eagletrt/handcart-hw/README.md

# Handcart

Battery charger controller board.
