eagletrt/handcart-hw/docs/hat_minimum.dxf

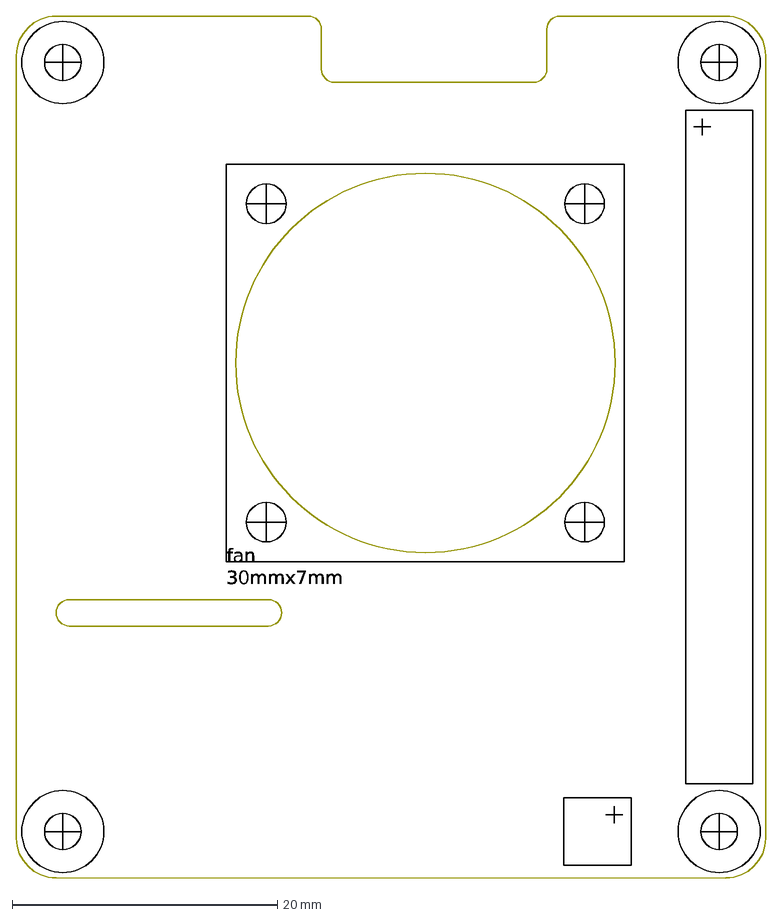
[picture p10: CAD file, 2021-08-04]
docs/hat_minimum.dxf
fan 30mmx7mm
