eagletrt/handcart-hw/(threads)

Thread 2 (2021-11-30):

Board v2 problems

volpx, 2021-11-30:

volpx, 2021-12-01:
- [ ] missing holes
- [ ] missing MCP reset stuff

volpx, 2021-12-01:
- [ ] Update shutdown labels

Closed 2024-01-30.

Thread 4 (2021-12-13):

SD relay coil has to be powered in a different way

mattebit, 2021-12-13:
Atm, the shutdown relay coil in the PCB cannot be closed by the raspy, because it needs an external action with the reset button

Closed 2024-01-30.

Thread 5 (2022-01-18):

Add LED support

mattebit, 2022-01-18:
Need to add support for RGB leds.
The GPIO pins
- 12
- 13
- 16
have to command a mosfet each, which will drive each LED channel (red green and blue).  Mosfets has to be added (rated for led current)
The connector to connect the leds to will have the three outputs from the mosfets + a GND pin, a +12V and a +5V.

mattebit, 2024-01-30:
Led added in new design

Closed 2024-01-30.

Thread 6 (2022-05-31):

LEDs logic is inverted

volpx, 2022-05-31:
All three led have the logic inverted from the transistors driving them according to an SCS signal.
TS_OFF led short to gnd should result in led off
_FAULT led short to gnd should result in led on

Closed 2024-01-30.

Thread 8 (2023-02-16):

Move the BMS connector, too close to shutdown relay K1, clip is not easy to press

mattebit, 2023-02-16:

Closed 2024-01-30.

Thread 9 (2023-06-25):

Add a RS232 connector or change the one already present

mattebit, 2023-06-25:
There is the need to connect a laptop to the handcart via serial, so the RS232 connector should be connected to the raspberry serial pins. At the moment the RS232 connector is connected to the brusa.
A switch could be added to choose to connect from the laptop to the raspi or to the brusa.

Closed 2024-01-30.

Thread 10 (2023-09-26):

Put the BMS connector directly on the PCB instead of having molex->cable->panel connector

mattebit, 2023-09-26:
Use the same TE ampseal connectors as the porchetto and ecu. Check also if it is possible to put another one for the brusa

Closed 2024-01-30.

Thread 12 (2023-10-27):

schematic review

thomasnonis, 2023-10-27:
## General
- [x] use a 0.050 in grid (realign everything after changing it)
- [x] Rnets are 4x0603, not 4x0612
- [x] specify the unit of resistor values (e.g. 22 -> 22R)
- [x] Add feedbacks for every single stupid signal (within reason, possibly analog)
- [x] RASPI with a "I", not "Y"
- [x] Place connectors together with their respective circuits in their sheets
- [x] Don't use custom symbols if not needed. Also keep body diode

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

## Power
- [x]  if +12V rail is used just for SDC, use VSD label
- [x] consider 2 separate fuses, one fo +12V and one for VSD
- [x]  place PWR_FLAGs at power net sources
- [x]  add LEDs for every generated power rail
- [x]  add fuse on main power input
- [x]  add fuse or pptc on dcdc2510 output
- [x] TSAL must be supplied by 24V
- [x] consider removing 12V aux supply from charger connector and replace them with spares. Then add spare power supply connector

## Connectors
- [x] add transient voltage protections (TVS) on all I/Os that interface with external systems/humans
- [x] add LPF and over/undervoltage protection (diode shunts) on all inputs
- [x] name every connector
- [x] why BMS is powered by 12V?
- [x] why does J10 have 6 pins instead of 4?
- [x] Molex outputs is not a great descriptive name. Just outputs would be better

## Shutdown
- [ ] consider finding new relay for 24V operation
- [x] why this specific mosfet to drive the relay? Consider 2N7002 which is already used in other circuits
- [x] both nets are inputs?
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
- [x] SD diode probably useless
- [x] Consider placing relay directly after VDC generation

## Discharge
- [x] why here pull-down is 10k and in other parts is 330k?
- [x] Don't use R_Small symbols. There is plenty of space, no need to make everything hyper compact

## Raspberry
- [x] consider adding a solder jumper on the 3V3 rail of the RPI. It has an internal regulator, which might interfere with the TexDCDC and result in unnecessary problems or power draw
- [x] Why 10k as I2C pull-up?

## Output
- [x] Why gate series resistors are 22R while they are 33R in other places?
- [x] Why 2512 resistors for just 200mW?
- [x] use TSAL in easy mode (just send on-off signal)
- [ ] think about power dissipation of all mosfets
- [x] no addressable LED strips :(

Kirseline, 2023-11-16:
[ ] Add reverse polarity protection on main power input
[ ] different CS for different spi chips
[ ] lower filter frequency on shutdown feedback

Closed 2023-12-15.

Thread 13 (2023-12-15):

Review

thomasnonis, 2023-12-15:
# Schematic

## General
- [ ] Use the standard part fields as in the template and fill them
- [ ] All datasheets must be local and with the core information highlighted
- [ ] Molex connectors are usually numbered Top-Bottom (check). Use correct symbols.
- [ ] 00_proj-lib is not included in the path

## Root

### Power in
- [ ] Eagle_Connectors:17762791 is not on the team library
- [ ] The Zener on the reverse polarity mosfet probably has too low of a voltage. It will not be able to carry 10A
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
- [ ] Reverse polarity protection mosfet footprint is wrong. Probably must be GDS or SDG
- [ ] Simply renaming a power port after placement will not change its net name. Need to create new port to actually have net renamed
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
- [ ] Do not change reference designators just on one side. These are not linked anymore
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

### To charger
- [ ] Charger connector footprint not in library

### Additional fan
- [ ] Sure that 1N4148W is SOD323?

# Layout
- [ ] Use filled zone instead of traces. Better for thermal reliefs
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
- [ ] This artifact brings no advantages. Decrease the zone's clearances or minimum widths to add more thermal relief. If this size is needed, might as well use fully filled zone (bad for soldering though)
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
- [ ] Is one VIA enough? Verify
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
- [ ] In general, routing traces as close as possible to each other is not good practice. If there is space, leave ample clearance
- [ ] Trace width is smaller at source and larger at load. Should be equal or the opposite
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
- [ ] If traces have to be able to carry the same current (bypass), they should be the same size.
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
- [ ] Could place it here on back layer
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
- [ ] Are 1.2mm needed for SDC? No need to reduce size, but probably oversized
- [ ] Add silkscreen description of every connector. If possible, also describe every single pin

Thread 16 (2024-03-13):

Connector RS232 (J26) not fitting between the other ones

mattebit, 2024-03-13:

Closed 2024-05-24.

Thread 17 (2024-03-13):

J30 connector interference with microSD card of raspi

mattebit, 2024-03-13:

Thread 21 (2024-06-06):

PON_CONTROL GPIO and SD_CONTROL GPIO are inverted in schematic

mattebit, 2024-06-06:
