eagletrt/handcart-hw/docs/handcart.pdf

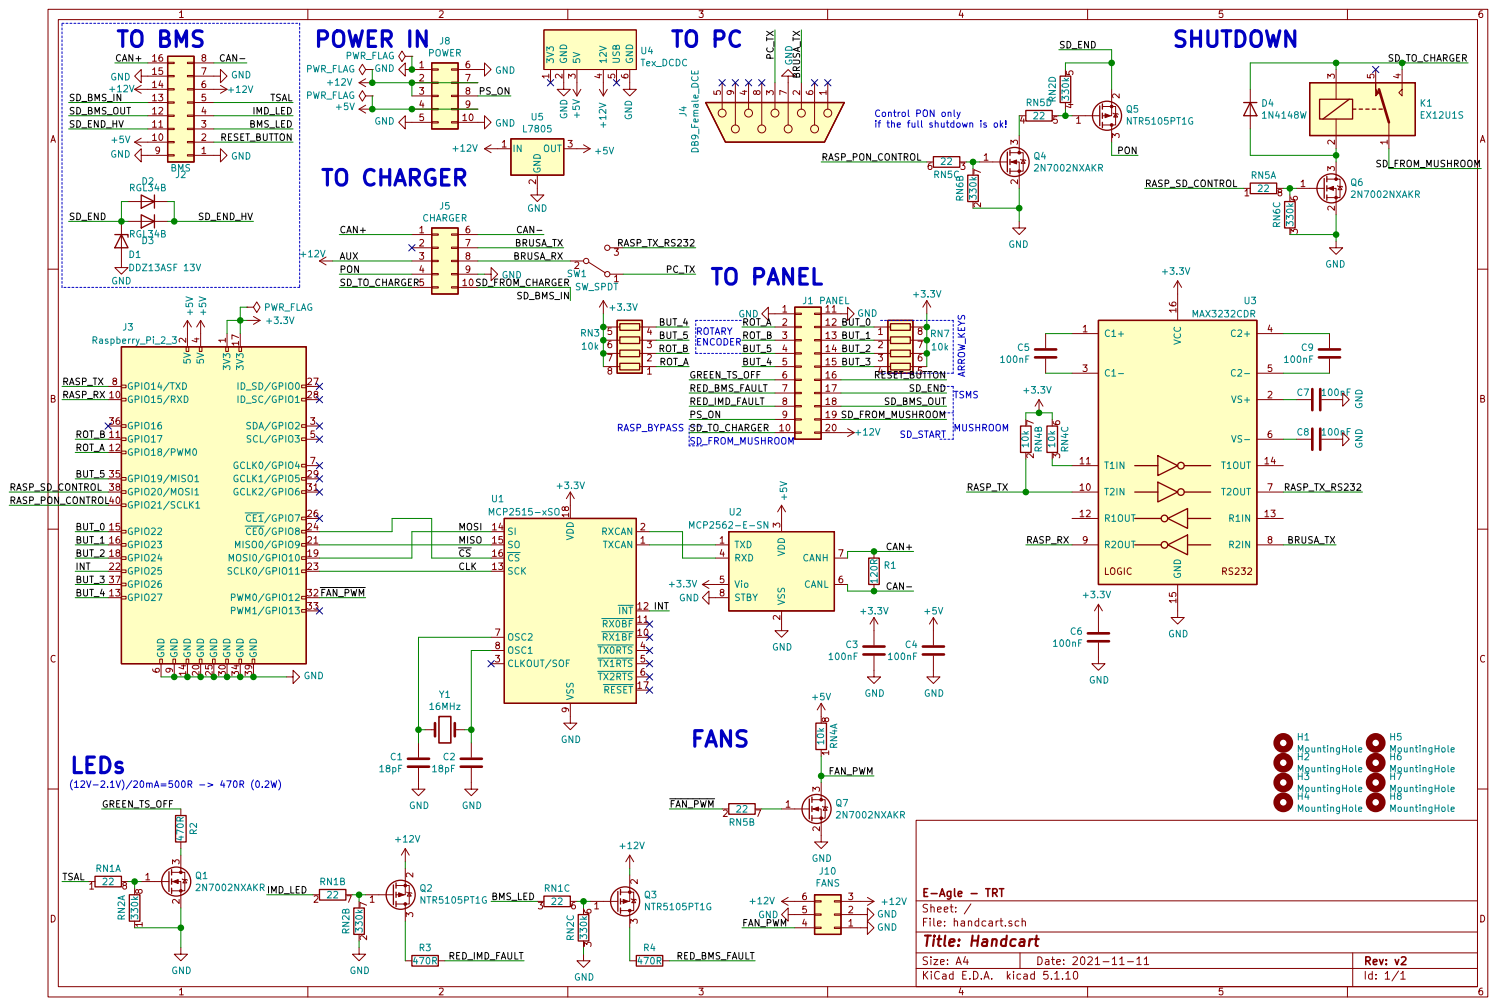
[picture p11: page 1]

PWR_FLAG
if the full shutdown is ok! FANS

3 RXD 4 Vio 5 CANL 6 CANH 7 STBY 8 U2 MCP2562-E-SN

2 3 Q2NTR5105PT1G
Id: 1/1 Title: Handcart File: handcart.sch Sheet: / E-Agle - TRT R3
