eagletrt/handcart-hw/handcart.kicad_pcb

## KiCad design handcart.kicad_pcb (2023-11-27)

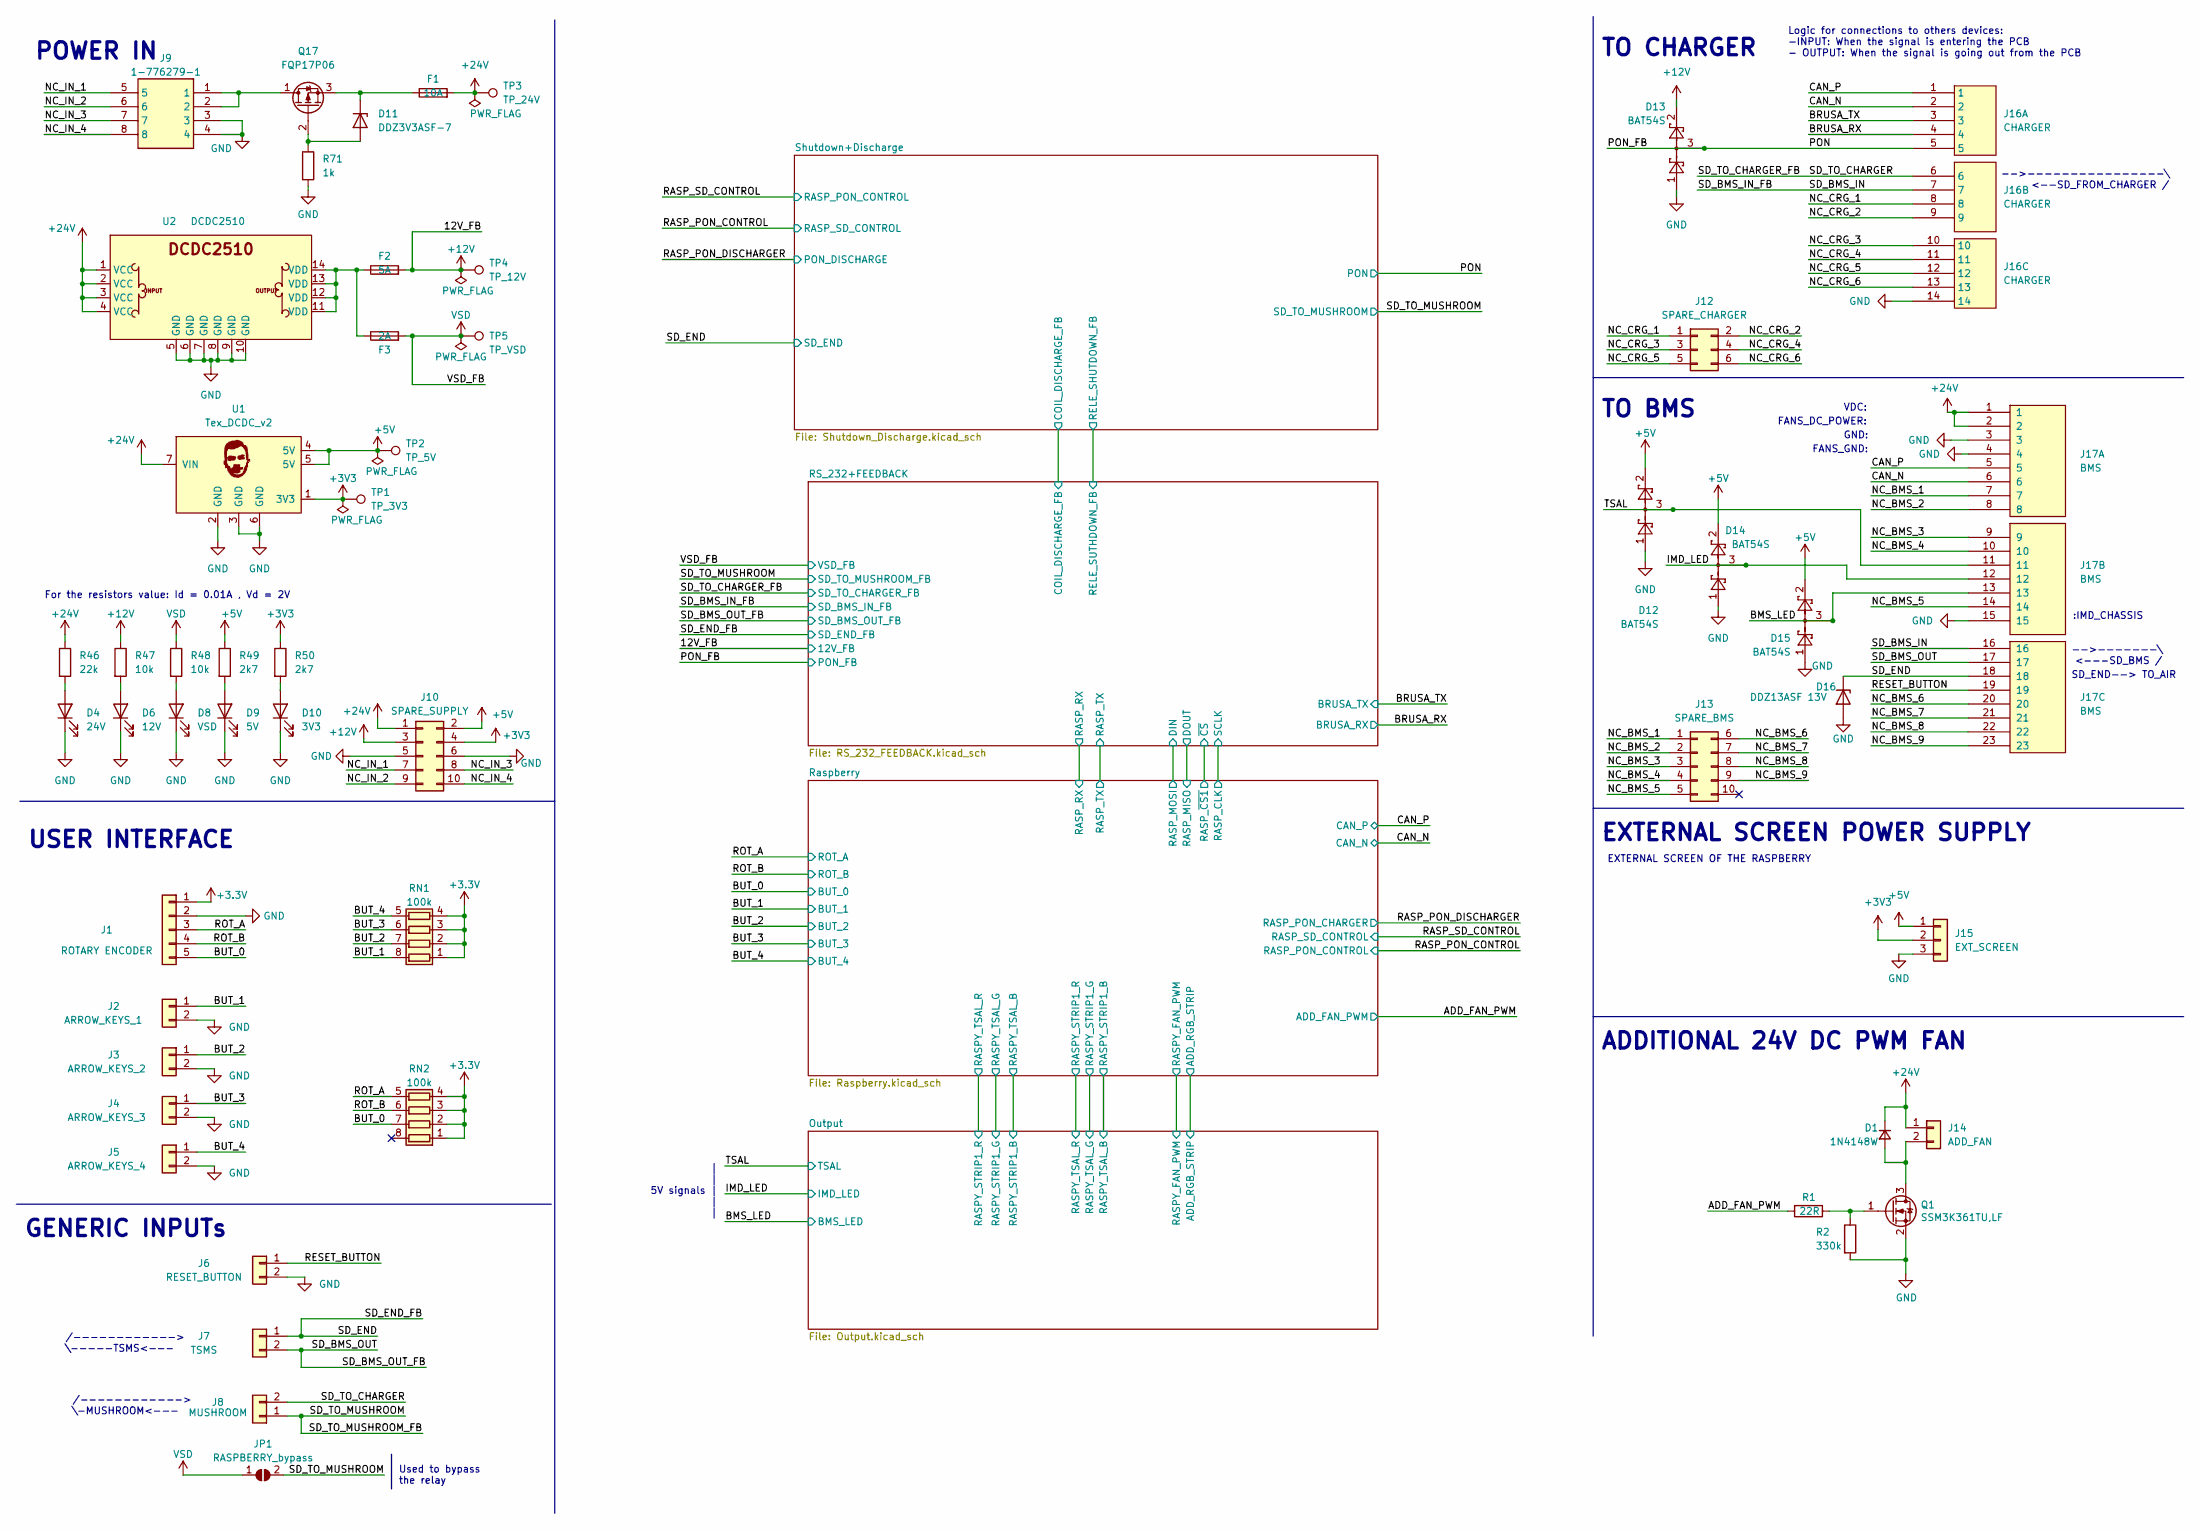
[picture p12: schematic handcart.kicad_sch]

Parts:
D1: 1N4148W; D_SOD-323_HandSoldering
D4: 24V; R_0805_2012Metric
D6: 12V; R_0805_2012Metric
D8: VSD; R_0805_2012Metric
D9: 5V; R_0805_2012Metric
D10: 3V3; R_0805_2012Metric
D11: DDZ3V3ASF-7; D_SOD-323
D12, D13, D14, D15: BAT54S; SOT-23
D16: DDZ13ASF 13V; D_SOD-323F
F1: 10A; Keystone-Fuseholder 3557-2
F2: 5A; Keystone-Fuseholder 3557-2
F3: 2A; Keystone-Fuseholder 3557-2
J1: ROTARY ENCODER; Molex_Micro-Fit_3.0_43650-0515_1x05_P3.00mm_Vertical
J2: ARROW_KEYS_1; Molex_Micro-Fit_3.0_43650-0215_1x02_P3.00mm_Vertical
J3: ARROW_KEYS_2; Molex_Micro-Fit_3.0_43650-0215_1x02_P3.00mm_Vertical
J4: ARROW_KEYS_3; Molex_Micro-Fit_3.0_43650-0215_1x02_P3.00mm_Vertical
J5: ARROW_KEYS_4; Molex_Micro-Fit_3.0_43650-0215_1x02_P3.00mm_Vertical
J6: RESET_BUTTON; Molex_Micro-Fit_3.0_43650-0215_1x02_P3.00mm_Vertical
J7: TSMS; Molex_Micro-Fit_3.0_43650-0215_1x02_P3.00mm_Vertical
J8: MUSHROOM; Molex_Micro-Fit_3.0_43650-0215_1x02_P3.00mm_Vertical
J9: 1-776279-1; 17762791; Mouser Part Number 571-1-776279-1
J10: SPARE_SUPPLY; Molex_Micro-Fit_3.0_43045-1012_2x05_P3.00mm_Vertical
J12: SPARE_CHARGER; Molex_Micro-Fit_3.0_43045-0612_2x03_P3.00mm_Vertical
J13: SPARE_BMS; Molex_Micro-Fit_3.0_43045-1012_2x05_P3.00mm_Vertical
J14: ADD_FAN; Molex_Micro-Fit_3.0_43650-0215_1x02_P3.00mm_Vertical
J15: EXT_SCREEN; Molex_Micro-Fit_3.0_43650-0315_1x03_P3.00mm_Vertical
J16: CHARGER; TE_776266-4
J17: BMS; TE_776087-4
JP1: RASPBERRY_bypass; SolderJumper-2_P1.3mm_Open_Pad1.0x1.5mm
Q1: SSM3K361TU,LF; SOTFL65P210X75-3N
Q17: FQP17P06; TO-220-3_Vertical
R1: 22R; R_0603_1608Metric
R2: 330k; R_0603_1608Metric
R46: 22k; R_0603_1608Metric
R47, R48: 10k; R_0603_1608Metric
R49, R50: 2k7; R_0603_1608Metric
R71: 1k; R_0603_1608Metric
RN1, RN2: 100k; R_Array_Convex_4x0603
TP1: TP_3V3; TestPoint_Pad_D2.0mm
TP2: TP_5V; TestPoint_Pad_D2.0mm
TP3: TP_24V; TestPoint_Pad_D2.0mm
TP4: TP_12V; TestPoint_Pad_D2.0mm
TP5: TP_VSD; TestPoint_Pad_D2.0mm
U1: Tex_DCDC_v2; Tex_DCDC_v2_horizontal
U2: DCDC2510; DCDC2510_Horizontal

Connections:
+3.3V: J1.1, RN1.1 (R1.1), RN1.2 (R2.1), RN1.3 (R3.1), RN1.4 (R4.1), RN2.1 (R1.1), RN2.2 (R2.1), RN2.3 (R3.1), RN2.4 (R4.1)
+3V3: J10.4, J15.2, R50.1, TP1.1, U1.1 (3V3); also elsewhere on the board
+5V: D12.2, D14.2, D15.2, J10.2, J15.1, R49.1, TP2.1, U1.4 (5V), U1.5 (5V); also elsewhere on the board
+12V: D13.2, F2.2, J10.3, R47.1, TP4.1; also elsewhere on the board
+24V: D1.1 (K), F1.2, J10.1, J14.1, J17.1, J17.2, R46.1, TP3.1, U1.7 (VIN), U2.1 (VCC), U2.2 (VCC), U2.3 (VCC), U2.4 (VCC); also elsewhere on the board
/ADD_FAN_PWM: R1.2; also elsewhere on the board
/BMS_LED: D15.3, J17.13; also elsewhere on the board
/BRUSA_RX: J16.4; also elsewhere on the board
/BRUSA_TX: J16.3; also elsewhere on the board
/BUT_0: J1.5, RN2.7 (R2.2); also elsewhere on the board
/BUT_1: J2.1, RN1.8 (R1.2); also elsewhere on the board
/BUT_2: J3.1, RN1.7 (R2.2); also elsewhere on the board
/BUT_3: J4.1, RN1.6 (R3.2); also elsewhere on the board
/BUT_4: J5.1, RN1.5 (R4.2); also elsewhere on the board
/CAN_N: J16.2, J17.6; also elsewhere on the board
/CAN_P: J16.1, J17.5; also elsewhere on the board
/IMD_LED: D14.3, J17.12; also elsewhere on the board
/NC_BMS_1: J13.1, J17.7
/NC_BMS_2: J13.2, J17.8
/NC_BMS_3: J13.3, J17.9
/NC_BMS_4: J13.4, J17.10
/NC_BMS_5: J13.5, J17.14
/NC_BMS_6: J13.6, J17.20
/NC_BMS_7: J13.7, J17.21
/NC_BMS_8: J13.8, J17.22
/NC_BMS_9: J13.9, J17.23
/NC_CRG_1: J12.1, J16.8
/NC_CRG_2: J12.2, J16.9
/NC_CRG_3: J12.3, J16.10
/NC_CRG_4: J12.4, J16.11
/NC_CRG_5: J12.5, J16.12
/NC_CRG_6: J12.6, J16.13
/NC_IN_1: J9.5, J10.7
/NC_IN_2: J9.6, J10.9
/NC_IN_3: J9.7, J10.8
/NC_IN_4: J9.8, J10.10
/PON: D13.3, J16.5; also elsewhere on the board
/RESET_BUTTON: J6.1, J17.19
/ROT_A: J1.3, RN2.5 (R4.2); also elsewhere on the board
/ROT_B: J1.4, RN2.6 (R3.2); also elsewhere on the board
/SD_BMS_IN: J16.7, J17.16; also elsewhere on the board
/SD_BMS_OUT: J7.2, J17.17; also elsewhere on the board
/SD_END: D16.1 (K), J7.1, J17.18; also elsewhere on the board
/SD_TO_CHARGER: J8.2, J16.6; also elsewhere on the board
/SD_TO_MUSHROOM: J8.1, JP1.2 (B); also elsewhere on the board
/TSAL: D12.3, J17.11; also elsewhere on the board
GND: D4.1 (K), D6.1 (K), D8.1 (K), D9.1 (K), D10.1 (K), D12.1, D13.1, D14.1, D15.1, D16.2 (A), J1.2, J2.2, J3.2, J4.2, J5.2, J6.2, J9.3, J9.4, J10.5, J10.6, J15.3, J16.14, J17.3, J17.4, J17.15, Q1.2 (S), R2.2, R71.2, U1.2 (GND), U1.3 (GND), U1.6 (GND), U2.5 (GND), U2.6 (GND), U2.7 (GND), U2.8 (GND), U2.9 (GND), U2.10 (GND); also elsewhere on the board
unnamed: D1.2 (A), J14.2, Q1.3 (D)
unnamed: D4.2 (A), R46.2
unnamed: D6.2 (A), R47.2
unnamed: D8.2 (A), R48.2
unnamed: D9.2 (A), R49.2
unnamed: D10.2 (A), R50.2
unnamed: D11.1 (K), F1.1, Q17.3 (S)
unnamed: D11.2 (A), Q17.2 (G), R71.1
unnamed: F2.1, F3.1, U2.11 (VDD), U2.12 (VDD), U2.13 (VDD), U2.14 (VDD)
unnamed: J9.1, J9.2, Q17.1 (D)
unnamed: Q1.1 (G), R1.1, R2.1
VCC: F3.2, JP1.1 (A), R48.1, TP5.1; also elsewhere on the board

Notes on the sheet:
-->-------\ <---SD_BMS /
POWER IN
EXTERNAL SCREEN OF THE RASPBERRY
TO BMS
FANS_GND:
TO CHARGER
-->----------------\ <--SD_FROM_CHARGER /
For the resistors value: Id = 0.01A , Vd = 2V
/------------> \-MUSHROOM<---
Used to bypass the relay
GENERIC INPUTs
/------------> \-----TSMS<---
VDC:
FANS_DC_POWER:
ADDITIONAL 24V DC PWM FAN
EXTERNAL SCREEN POWER SUPPLY
Logic for connections to others devices: -INPUT: When the signal is entering the PCB - OUTPUT: When the signal is going out from the PCB
| | 5V signals | | |
SD_END--> TO_AIR
GND:
:IMD_CHASSIS
USER INTERFACE

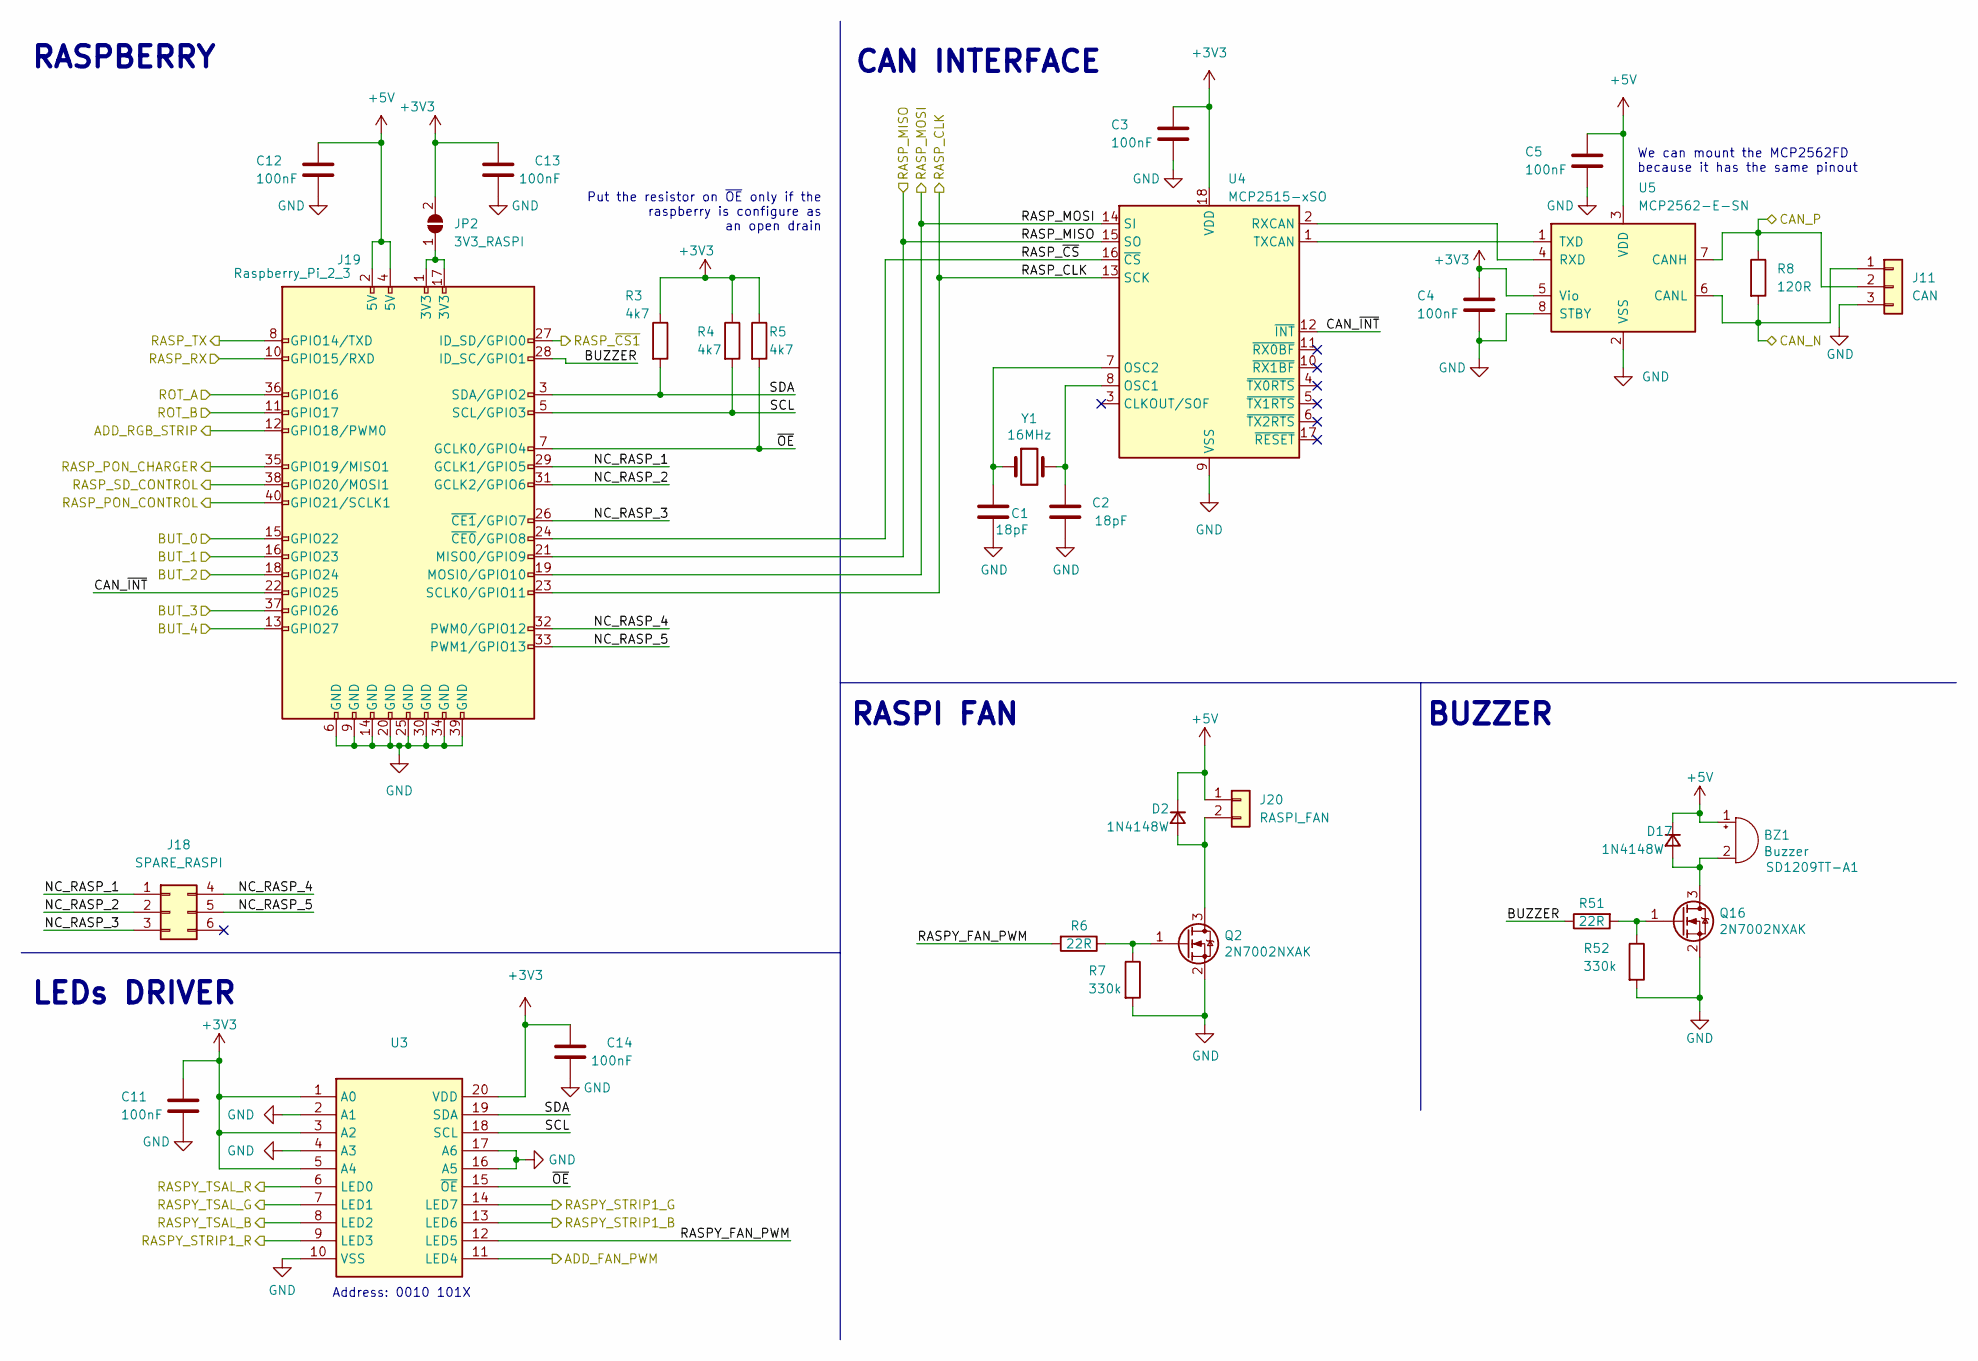
[picture p13: schematic Raspberry.kicad_sch]

Parts:
BZ1: Buzzer; Buzzer_TDK_PS1240P02BT_D12.2mm_H6.5mm
C1, C2: 18pF; R_0603_1608Metric
C3, C4, C5, C11, C12, C13, C14: 100nF; R_0805_2012Metric
D2, D17: 1N4148W; D_SOD-323_HandSoldering
J11: CAN; Molex_Micro-Fit_3.0_43650-0315_1x03_P3.00mm_Vertical
J18: SPARE_RASPI; Molex_Micro-Fit_3.0_43045-0612_2x03_P3.00mm_Vertical
J19: Raspberry_Pi_2_3; raspberrypi_hat_template
J20: RASPI_FAN; Molex_Micro-Fit_3.0_43650-0215_1x02_P3.00mm_Vertical
JP2: 3V3_RASPI; SolderJumper-2_P1.3mm_Open_RoundedPad1.0x1.5mm
Q2, Q16: 2N7002NXAK; SOT-23
R3, R4, R5: 4k7; R_0603_1608Metric
R6, R51: 22R; R_0603_1608Metric
R7, R52: 330k; R_0603_1608Metric
R8: 120R; R_0603_1608Metric
U3: PCA9634PW,118; SOP65P640X110-20N; Mouser Part Number 771-PCA9634PW-T
U4: MCP2515-xSO; SOIC-18W_7.5x11.6mm_P1.27mm
U5: MCP2562-E-SN; SOIC-8_3.9x4.9mm_P1.27mm
Y1: 16MHz; Crystal_HC49-4H_Vertical

Connections:
+3V3: C3.1, C4.1, C11.1, C13.1, C14.1, JP2.2 (B), R3.1, R4.1, R5.1, U3.1 (A0), U3.3 (A2), U3.5 (A4), U3.20 (VDD), U4.18 (VDD), U5.5 (Vio); also elsewhere on the board
+5V: BZ1.1 (-), C5.1, C12.1, D2.1 (K), D17.1 (K), J19.2 (5V), J19.4 (5V), J20.1, U5.3 (VDD); also elsewhere on the board
/ADD_FAN_PWM: U3.11 (LED4); also elsewhere on the board
/BUT_0: J19.15 (GPIO22); also elsewhere on the board
/BUT_1: J19.16 (GPIO23); also elsewhere on the board
/BUT_2: J19.18 (GPIO24); also elsewhere on the board
/BUT_3: J19.37 (GPIO26); also elsewhere on the board
/BUT_4: J19.13 (GPIO27); also elsewhere on the board
/CAN_N: J11.1, R8.2, U5.6 (CANL); also elsewhere on the board
/CAN_P: J11.2, R8.1, U5.7 (CANH); also elsewhere on the board
/Output/ADD_RGB_STRIP: J19.12 (GPIO18/PWM0); also elsewhere on the board
/Output/RASPY_STRIP1_B: U3.8 (LED2); also elsewhere on the board
/Output/RASPY_STRIP1_G: U3.7 (LED1); also elsewhere on the board
/Output/RASPY_STRIP1_R: U3.6 (LED0); also elsewhere on the board
/Output/RASPY_TSAL_B: U3.13 (LED6); also elsewhere on the board
/Output/RASPY_TSAL_G: U3.14 (LED7); also elsewhere on the board
/Output/RASPY_TSAL_R: U3.9 (LED3); also elsewhere on the board
/RASP_PON_CONTROL: J19.40 (GPIO21/SCLK1); also elsewhere on the board
/RASP_PON_DISCHARGER: J19.35 (GPIO19/MISO1); also elsewhere on the board
/RASP_SD_CONTROL: J19.38 (GPIO20/MOSI1); also elsewhere on the board
/ROT_A: J19.36 (GPIO16); also elsewhere on the board
/ROT_B: J19.11 (GPIO17); also elsewhere on the board
/RS_232+FEEDBACK/RASP_RX: J19.10 (GPIO15/RXD); also elsewhere on the board
/RS_232+FEEDBACK/RASP_TX: J19.8 (GPIO14/TXD); also elsewhere on the board
/RS_232+FEEDBACK/~CS: J19.27 (ID_SD/GPIO0); also elsewhere on the board
/Raspberry/BUZZER: J19.28 (ID_SC/GPIO1), R51.1
/Raspberry/CAN_~INT: J19.22 (GPIO25), U4.12 (~INT)
/Raspberry/NC_RASP_1: J18.1, J19.29 (GCLK1/GPIO5)
/Raspberry/NC_RASP_2: J18.2, J19.31 (GCLK2/GPIO6)
/Raspberry/NC_RASP_3: J18.3, J19.26 (~CE1/GPIO7)
/Raspberry/NC_RASP_4: J18.4, J19.32 (PWM0/GPIO12)
/Raspberry/NC_RASP_5: J18.5, J19.33 (PWM1/GPIO13)
/Raspberry/RASPY_FAN_PWM: R6.2, U3.12 (LED5)
/Raspberry/RASP_CLK: J19.23 (SCLK0/GPIO11), U4.13 (SCK); also elsewhere on the board
/Raspberry/RASP_MISO: J19.21 (MISO0/GPIO9), U4.15 (SO); also elsewhere on the board
/Raspberry/RASP_MOSI: J19.19 (MOSI0/GPIO10), U4.14 (SI); also elsewhere on the board
/Raspberry/RASP_~CS: J19.24 (~CE0/GPIO8), U4.16 (~CS)
/Raspberry/SCL: J19.5 (SCL/GPIO3), R4.2, U3.18 (SCL)
/Raspberry/SDA: J19.3 (SDA/GPIO2), R3.2, U3.19 (SDA)
/Raspberry/~OE: J19.7 (GCLK0/GPIO4), R5.2, U3.15 (~OE)
GND: C1.2, C2.2, C3.2, C4.2, C5.2, C11.2, C12.2, C13.2, C14.2, J11.3, J19.6 (GND), J19.9 (GND), J19.14 (GND), J19.20 (GND), J19.25 (GND), J19.30 (GND), J19.34 (GND), J19.39 (GND), Q2.2 (S), Q16.2 (S), R7.2, R52.2, U3.2 (A1), U3.4 (A3), U3.10 (VSS), U3.16 (A5), U3.17 (A6), U4.9 (VSS), U5.2 (VSS), U5.8 (STBY); also elsewhere on the board
unnamed: BZ1.2 (+), D17.2 (A), Q16.3 (D)
unnamed: C1.1, U4.7 (OSC2), Y1.1
unnamed: C2.1, U4.8 (OSC1), Y1.2
unnamed: D2.2 (A), J20.2, Q2.3 (D)
unnamed: J19.1 (3V3), J19.17 (3V3), JP2.1 (A)
unnamed: Q2.1 (G), R6.1, R7.1
unnamed: Q16.1 (G), R51.2, R52.1
unnamed: U4.1 (TXCAN), U5.1 (TXD)
unnamed: U4.2 (RXCAN), U5.4 (RXD)

Notes on the sheet:
RASPI FAN
RASPBERRY
BUZZER
Address: 0010 101X
LEDs DRIVER
We can mount the MCP2562FD because it has the same pinout
Put the resistor on ~{OE} only if the raspberry is configure as an open drain
CAN INTERFACE

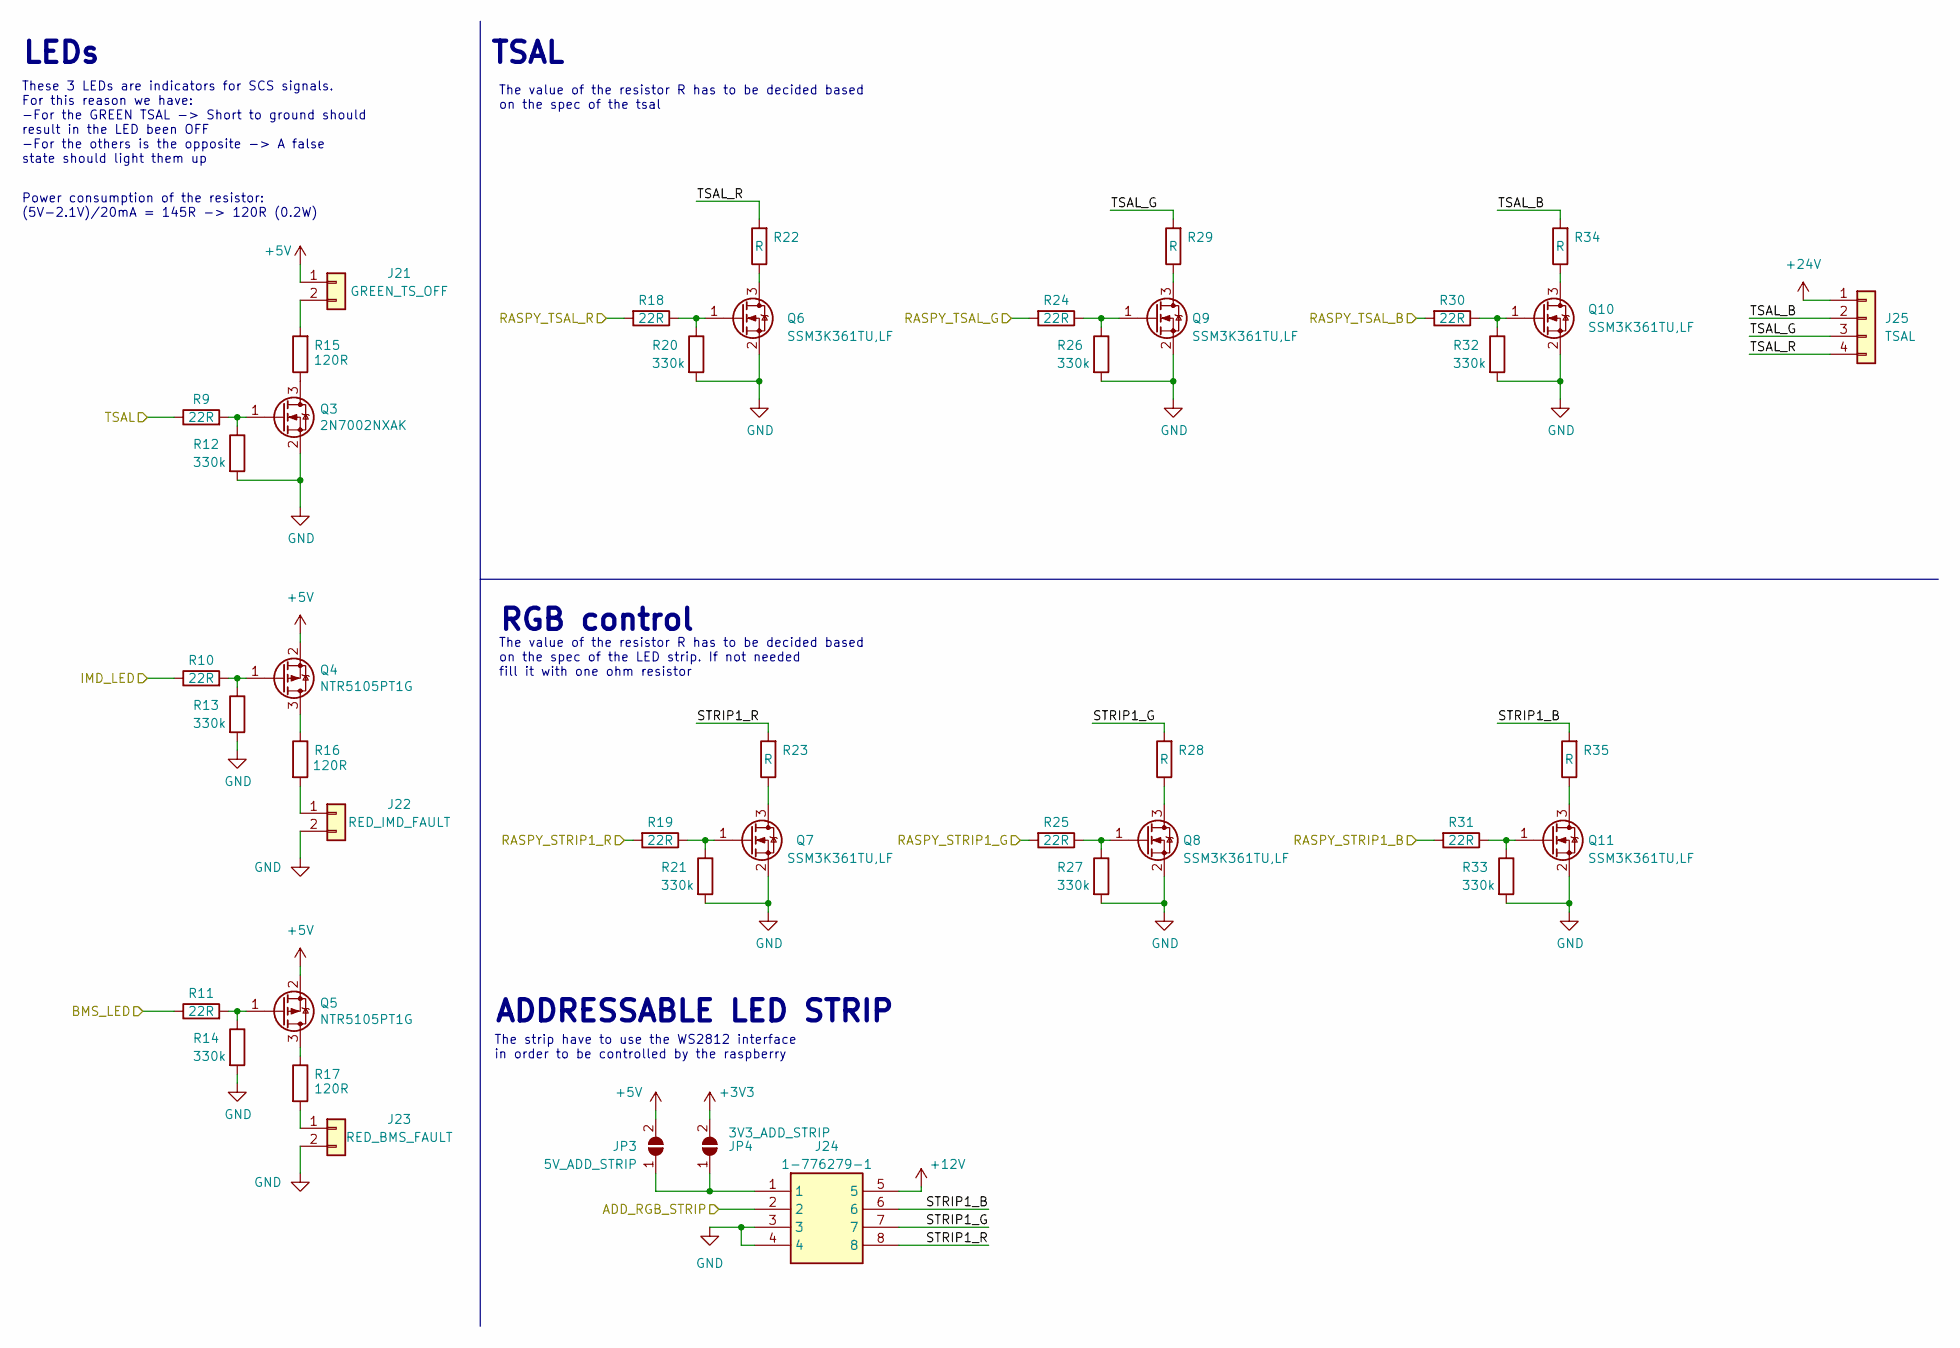
[picture p14: schematic Output.kicad_sch]

Parts:
J21: GREEN_TS_OFF; Molex_Micro-Fit_3.0_43650-0215_1x02_P3.00mm_Vertical
J22: RED_IMD_FAULT; Molex_Micro-Fit_3.0_43650-0215_1x02_P3.00mm_Vertical
J23: RED_BMS_FAULT; Molex_Micro-Fit_3.0_43650-0215_1x02_P3.00mm_Vertical
J24: 1-776279-1; 17762791; Mouser Part Number 571-1-776279-1
J25: TSAL; Molex_Micro-Fit_3.0_43650-0415_1x04_P3.00mm_Vertical
JP3: 5V_ADD_STRIP; SolderJumper-2_P1.3mm_Open_RoundedPad1.0x1.5mm
JP4: 3V3_ADD_STRIP; SolderJumper-2_P1.3mm_Open_RoundedPad1.0x1.5mm
Q3: 2N7002NXAK; SOT-23
Q4, Q5: NTR5105PT1G; SOT-23
Q6, Q7, Q8, Q9, Q10, Q11: SSM3K361TU,LF; SOTFL65P210X75-3N; Mouser Part Number 757-SSM3K361TULF
R9, R10, R11, R18, R19, R24, R25, R30, R31: 22R; R_0603_1608Metric
R12, R13, R14, R20, R21, R26, R27, R32, R33: 330k; R_0603_1608Metric
R15, R16, R17: 120R; R_0603_1608Metric
R22, R23, R28, R29, R34, R35: R; R_0805_2012Metric

Connections:
+3V3: JP4.2 (B); also elsewhere on the board
+5V: J21.1, JP3.2 (B), Q4.2 (S), Q5.2 (S); also elsewhere on the board
+12V: J24.5; also elsewhere on the board
+24V: J25.1; also elsewhere on the board
/BMS_LED: R11.1; also elsewhere on the board
/IMD_LED: R10.1; also elsewhere on the board
/Output/ADD_RGB_STRIP: J24.2; also elsewhere on the board
/Output/RASPY_STRIP1_B: R31.2; also elsewhere on the board
/Output/RASPY_STRIP1_G: R25.2; also elsewhere on the board
/Output/RASPY_STRIP1_R: R19.2; also elsewhere on the board
/Output/RASPY_TSAL_B: R30.2; also elsewhere on the board
/Output/RASPY_TSAL_G: R24.2; also elsewhere on the board
/Output/RASPY_TSAL_R: R18.2; also elsewhere on the board
/Output/STRIP1_B: J24.6, R35.2
/Output/STRIP1_G: J24.7, R28.2
/Output/STRIP1_R: J24.8, R23.2
/Output/TSAL_B: J25.2, R34.2
/Output/TSAL_G: J25.3, R29.2
/Output/TSAL_R: J25.4, R22.2
/TSAL: R9.1; also elsewhere on the board
GND: J22.2, J23.2, J24.3, J24.4, Q3.2 (S), Q6.2 (S), Q7.2 (S), Q8.2 (S), Q9.2 (S), Q10.2 (S), Q11.2 (S), R12.2, R13.2, R14.2, R20.2, R21.2, R26.2, R27.2, R32.2, R33.2; also elsewhere on the board
unnamed: J21.2, R15.2
unnamed: J22.1, R16.2
unnamed: J23.1, R17.2
unnamed: J24.1, JP3.1 (A), JP4.1 (A)
unnamed: Q3.1 (G), R9.2, R12.1
unnamed: Q3.3 (D), R15.1
unnamed: Q4.1 (G), R10.2, R13.1
unnamed: Q4.3 (D), R16.1
unnamed: Q5.1 (G), R11.2, R14.1
unnamed: Q5.3 (D), R17.1
unnamed: Q6.1 (G), R18.1, R20.1
unnamed: Q6.3 (D), R22.1
unnamed: Q7.1 (G), R19.1, R21.1
unnamed: Q7.3 (D), R23.1
unnamed: Q8.1 (G), R25.1, R27.1
unnamed: Q8.3 (D), R28.1
unnamed: Q9.1 (G), R24.1, R26.1
unnamed: Q9.3 (D), R29.1
unnamed: Q10.1 (G), R30.1, R32.1
unnamed: Q10.3 (D), R34.1
unnamed: Q11.1 (G), R31.1, R33.1
unnamed: Q11.3 (D), R35.1

Notes on the sheet:
ADDRESSABLE LED STRIP
These 3 LEDs are indicators for SCS signals. For this reason we have: -For the GREEN TSAL -> Short to ground should result in the LED been OFF -For the others is the opposite -> A false state should light them up
RGB control
LEDs
TSAL
Power consumption of the resistor: (5V-2.1V)/20mA = 145R -> 120R (0.2W)
The value of the resistor R has to be decided based on the spec of the LED strip. If not needed fill it with one ohm resistor
The value of the resistor R has to be decided based on the spec of the tsal
The strip have to use the WS2812 interface in order to be controlled by the raspberry

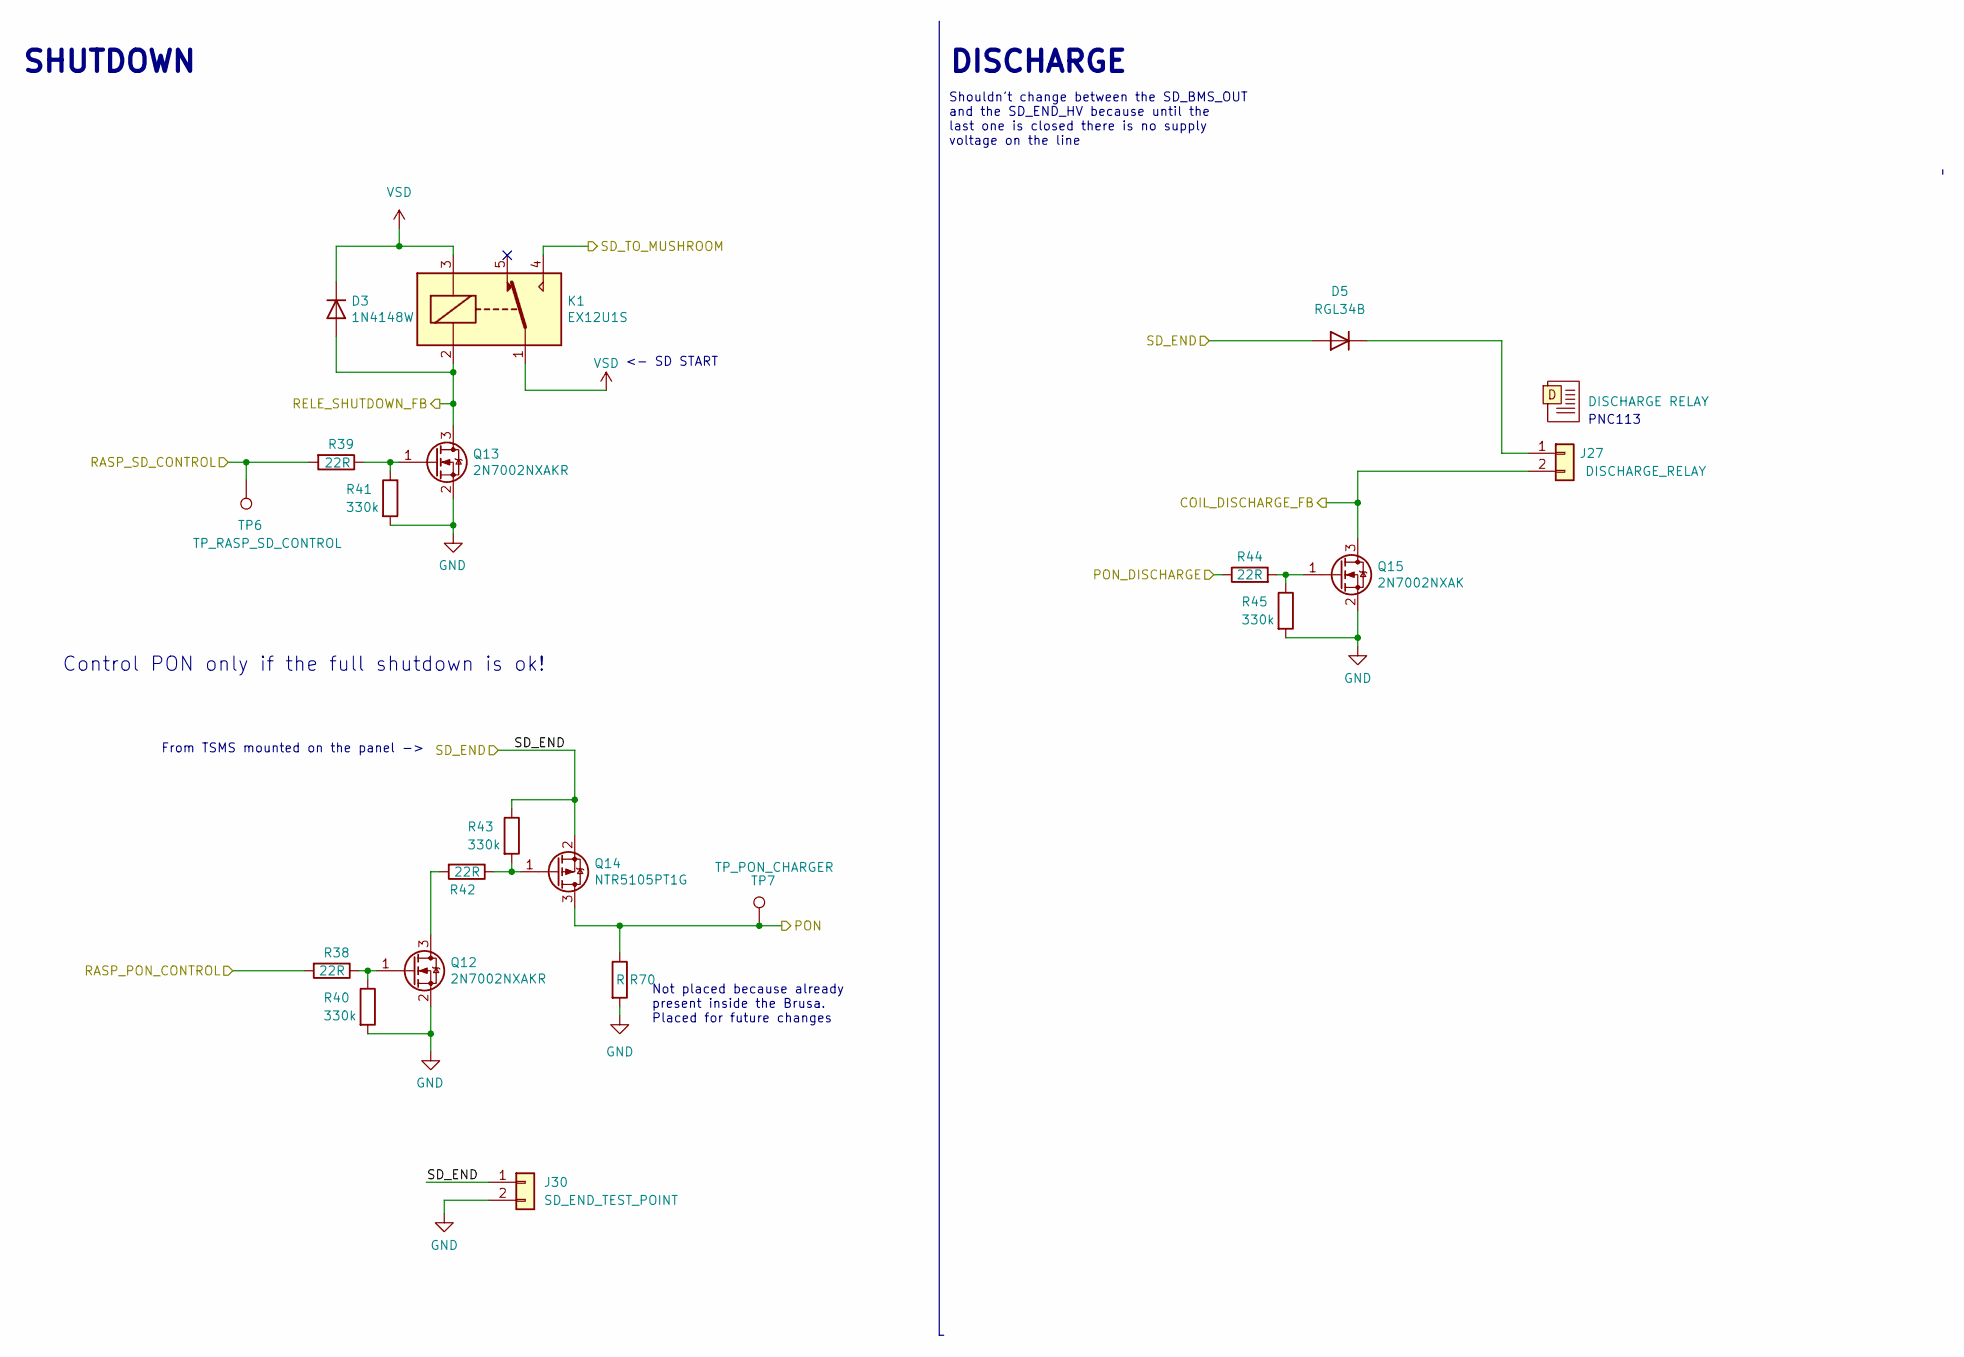
[picture p15: schematic Shutdown_Discharge.kicad_sch]

Parts:
D3: 1N4148W; D_SOD-123
D5: RGL34B; D_MiniMELF
D7: DISCHARGE RELAY
J27: DISCHARGE_RELAY; Molex_Micro-Fit_3.0_43650-0215_1x02_P3.00mm_Vertical
J30: SD_END_TEST_POINT; Molex_Micro-Fit_3.0_43650-0215_1x02_P3.00mm_Vertical
K1: EX12U1S
Q12, Q13: 2N7002NXAKR; SOT-23
Q14: NTR5105PT1G; SOT-23
Q15: 2N7002NXAK; SOT-23
R38, R39, R42, R44: 22R; R_0603_1608Metric
R40, R41, R43, R45: 330k; R_0603_1608Metric
R70: R; R_0805_2012Metric
TP6: TP_RASP_SD_CONTROL; TestPoint_Pad_D2.0mm
TP7: TP_PON_CHARGER; TestPoint_Pad_D2.0mm

Connections:
/PON: Q14.3 (D), R70.1, TP7.1; also elsewhere on the board
/RASP_PON_CONTROL: R39.2, TP6.1; also elsewhere on the board
/RASP_PON_DISCHARGER: R44.1; also elsewhere on the board
/RASP_SD_CONTROL: R38.2; also elsewhere on the board
/RS_232+FEEDBACK/COIL_DISCHARGE_FB: J27.2, Q15.3 (D); also elsewhere on the board
/RS_232+FEEDBACK/RELE_SUTHDOWN_FB: D3.2 (A), K1.2, Q13.3 (D); also elsewhere on the board
/SD_END: D5.2 (A), J30.1, Q14.2 (S), R43.1; also elsewhere on the board
/SD_TO_MUSHROOM: K1.4; also elsewhere on the board
GND: J30.2, Q12.2 (S), Q13.2 (S), Q15.2 (S), R40.2, R41.2, R45.2, R70.2; also elsewhere on the board
unnamed: D5.1 (K), J27.1
unnamed: Q12.1 (G), R38.1, R40.1
unnamed: Q12.3 (D), R42.2
unnamed: Q13.1 (G), R39.1, R41.1
unnamed: Q14.1 (G), R42.1, R43.2
unnamed: Q15.1 (G), R44.2, R45.1
VCC: D3.1 (K), K1.1, K1.3; also elsewhere on the board

Notes on the sheet:
From TSMS mounted on the panel ->
<- SD START
SHUTDOWN
Shouldn't change between the SD_BMS_OUT and the SD_END_HV because until the last one is closed there is no supply voltage on the line
Not placed because already present inside the Brusa. Placed for future changes
PNC113
DISCHARGE
Control PON only if the full shutdown is ok!
