eagletrt/handcart-hw/handcart.kicad_pcb

## KiCad design handcart.kicad_pcb (continued)

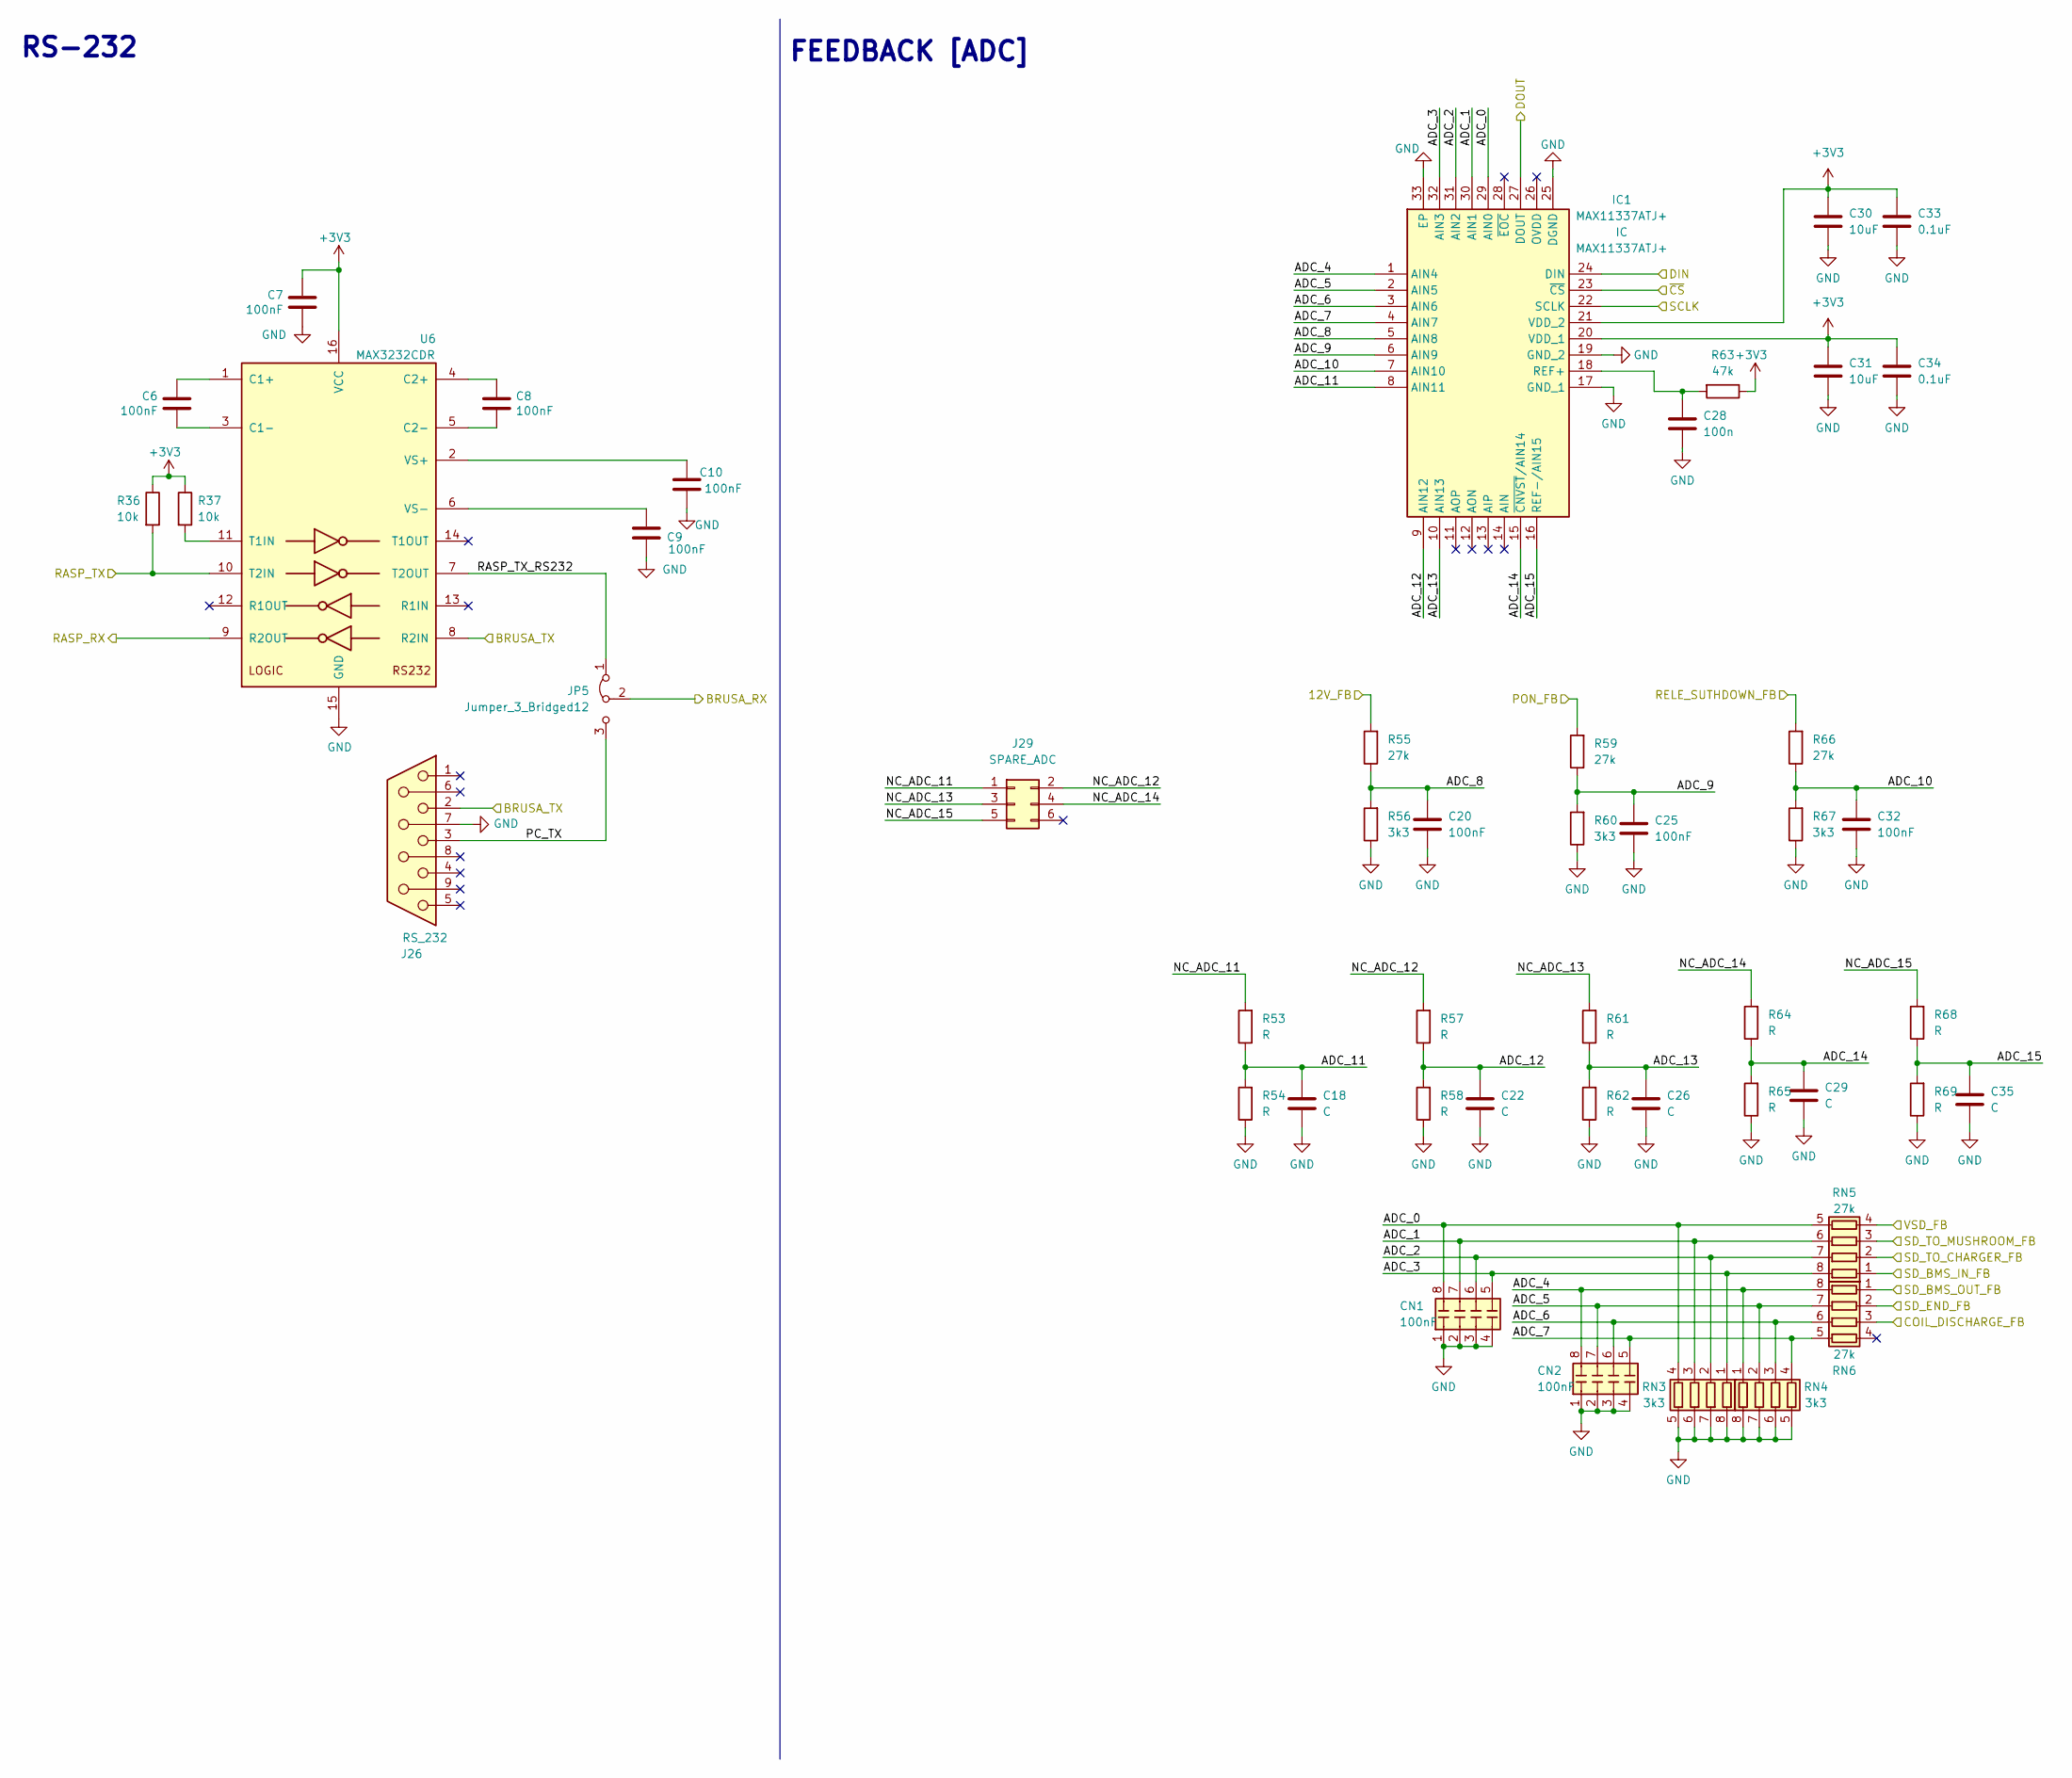
[picture p16: schematic RS_232_FEEDBACK.kicad_sch]

Parts:
C6, C7, C8, C9, C10, C20, C25, C32: 100nF; R_0603_1608Metric
C18, C22, C26, C29, C35: C; R_0805_2012Metric
C28: 100n; R_0603_1608Metric
C30, C31: 10uF; R_0603_1608Metric
C33, C34: 0.1uF; R_0603_1608Metric
CN1, CN2: 100nF; R_Array_Concave_4x0603; Mouser 581-W3A4YC104KAT2A
IC1: MAX11337ATJ+; QFN50P500X500X80-33N; Mouser Part Number 700-MAX11337ATJ+
J26: RS_232; DSUB-9_Female_Horizontal_P2.77x2.84mm_EdgePinOffset7.70mm_H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
J29: SPARE_ADC; Molex_Micro-Fit_3.0_43045-0612_2x03_P3.00mm_Vertical
JP5: Jumper_3_Bridged12; PinHeader_1x03_P2.54mm_Vertical
R36, R37: 10k; R_0603_1608Metric
R53, R54, R57, R58, R61, R62, R64, R65, R68, R69: R; R_0805_2012Metric
R55, R59, R66: 27k; R_0603_1608Metric
R56, R60, R67: 3k3; R_0603_1608Metric
R63: 47k; R_0603_1608Metric
RN3, RN4: 3k3; R_Array_Convex_4x0603
RN5, RN6: 27k; R_Array_Convex_4x0603
U6: MAX3232CDR; SOIC-16_3.9x9.9mm_P1.27mm

Connections:
+3V3: C7.1, C30.1, C31.1, C33.1, C34.1, IC1.20 (VDD_1), IC1.21 (VDD_2), R36.1, R37.1, R63.1, U6.16 (VCC); also elsewhere on the board
+12V: R55.2; also elsewhere on the board
/BRUSA_RX: JP5.2 (C); also elsewhere on the board
/BRUSA_TX: J26.2, U6.8 (R2IN); also elsewhere on the board
/PON: R59.2; also elsewhere on the board
/RS_232+FEEDBACK/ADC_0: CN1.8 (R1.2), IC1.29 (AIN0), RN3.4 (R4.1), RN5.5 (R4.2)
/RS_232+FEEDBACK/ADC_1: CN1.7 (R2.2), IC1.30 (AIN1), RN3.3 (R3.1), RN5.6 (R3.2)
/RS_232+FEEDBACK/ADC_2: CN1.6 (R3.2), IC1.31 (AIN2), RN3.2 (R2.1), RN5.7 (R2.2)
/RS_232+FEEDBACK/ADC_3: CN1.5 (R4.2), IC1.32 (AIN3), RN3.1 (R1.1), RN5.8 (R1.2)
/RS_232+FEEDBACK/ADC_4: CN2.8 (R1.2), IC1.1 (AIN4), RN4.1 (R1.1), RN6.8 (R1.2)
/RS_232+FEEDBACK/ADC_5: CN2.7 (R2.2), IC1.2 (AIN5), RN4.2 (R2.1), RN6.7 (R2.2)
/RS_232+FEEDBACK/ADC_6: CN2.6 (R3.2), IC1.3 (AIN6), RN4.3 (R3.1), RN6.6 (R3.2)
/RS_232+FEEDBACK/ADC_7: CN2.5 (R4.2), IC1.4 (AIN7), RN4.4 (R4.1), RN6.5 (R4.2)
/RS_232+FEEDBACK/ADC_8: C20.1, IC1.5 (AIN8), R55.1, R56.2
/RS_232+FEEDBACK/ADC_9: C25.1, IC1.6 (AIN9), R59.1, R60.2
/RS_232+FEEDBACK/ADC_10: C32.1, IC1.7 (AIN10), R66.1, R67.2
/RS_232+FEEDBACK/ADC_11: C18.1, IC1.8 (AIN11), R53.1, R54.2
/RS_232+FEEDBACK/ADC_12: C22.1, IC1.9 (AIN12), R57.1, R58.2
/RS_232+FEEDBACK/ADC_13: C26.1, IC1.10 (AIN13), R61.1, R62.2
/RS_232+FEEDBACK/ADC_14: C29.1, IC1.15 (~CNVST/AIN14), R64.1, R65.2
/RS_232+FEEDBACK/ADC_15: C35.1, IC1.16 (REF-/AIN15), R68.1, R69.2
/RS_232+FEEDBACK/COIL_DISCHARGE_FB: RN6.3 (R3.1); also elsewhere on the board
/RS_232+FEEDBACK/NC_ADC_11: J29.1, R53.2
/RS_232+FEEDBACK/NC_ADC_12: J29.2, R57.2
/RS_232+FEEDBACK/NC_ADC_13: J29.3, R61.2
/RS_232+FEEDBACK/NC_ADC_14: J29.4, R64.2
/RS_232+FEEDBACK/NC_ADC_15: J29.5, R68.2
/RS_232+FEEDBACK/PC_TX: J26.3, JP5.3 (B)
/RS_232+FEEDBACK/RASP_RX: U6.9 (R2OUT); also elsewhere on the board
/RS_232+FEEDBACK/RASP_TX: R36.2, U6.10 (T2IN); also elsewhere on the board
/RS_232+FEEDBACK/RASP_TX_RS232: JP5.1 (A), U6.7 (T2OUT)
/RS_232+FEEDBACK/RELE_SUTHDOWN_FB: R66.2; also elsewhere on the board
/RS_232+FEEDBACK/~CS: IC1.23 (~CS); also elsewhere on the board
/Raspberry/RASP_CLK: IC1.22 (SCLK); also elsewhere on the board
/Raspberry/RASP_MISO: IC1.27 (DOUT); also elsewhere on the board
/Raspberry/RASP_MOSI: IC1.24 (DIN); also elsewhere on the board
/SD_BMS_IN: RN5.1 (R1.1); also elsewhere on the board
/SD_BMS_OUT: RN6.1 (R1.1); also elsewhere on the board
/SD_END: RN6.2 (R2.1); also elsewhere on the board
/SD_TO_CHARGER: RN5.2 (R2.1); also elsewhere on the board
/SD_TO_MUSHROOM: RN5.3 (R3.1); also elsewhere on the board
GND: C7.2, C9.2, C10.2, C18.2, C20.2, C22.2, C25.2, C26.2, C28.2, C29.2, C30.2, C31.2, C32.2, C33.2, C34.2, C35.2, CN1.1 (R1.1), CN1.2 (R2.1), CN1.3 (R3.1), CN1.4 (R4.1), CN2.1 (R1.1), CN2.2 (R2.1), CN2.3 (R3.1), CN2.4 (R4.1), IC1.17 (GND_1), IC1.19 (GND_2), IC1.25 (DGND), IC1.33 (EP), J26.7, R54.1, R56.1, R58.1, R60.1, R62.1, R65.1, R67.1, R69.1, RN3.5 (R4.2), RN3.6 (R3.2), RN3.7 (R2.2), RN3.8 (R1.2), RN4.5 (R4.2), RN4.6 (R3.2), RN4.7 (R2.2), RN4.8 (R1.2), U6.15 (GND); also elsewhere on the board
unnamed: C6.1, U6.1 (C1+)
unnamed: C6.2, U6.3 (C1-)
unnamed: C8.1, U6.4 (C2+)
unnamed: C8.2, U6.5 (C2-)
unnamed: C9.1, U6.6 (VS-)
unnamed: C10.1, U6.2 (VS+)
unnamed: C28.1, IC1.18 (REF+), R63.2
unnamed: R37.2, U6.11 (T1IN)
VCC: RN5.4 (R4.1); also elsewhere on the board

Notes on the sheet:
RS-232
FEEDBACK [ADC]

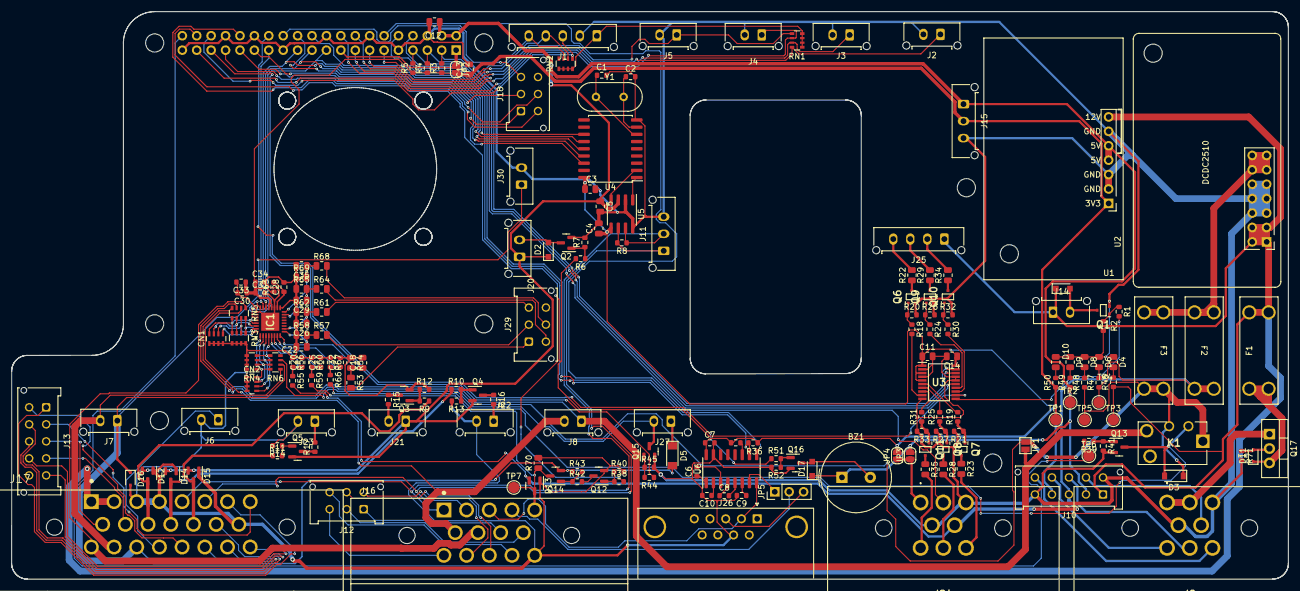
[picture p17: board handcart.kicad_pcb from above]

Board: 2 copper layers, 225.0 x 100.0 mm, 193 parts (1 on the bottom side), 163 nets.
