eagletrt/handcart-hw/handcart V6.kicad_pcb

## KiCad design handcart V6.kicad_pcb (2023-10-26, an earlier design)

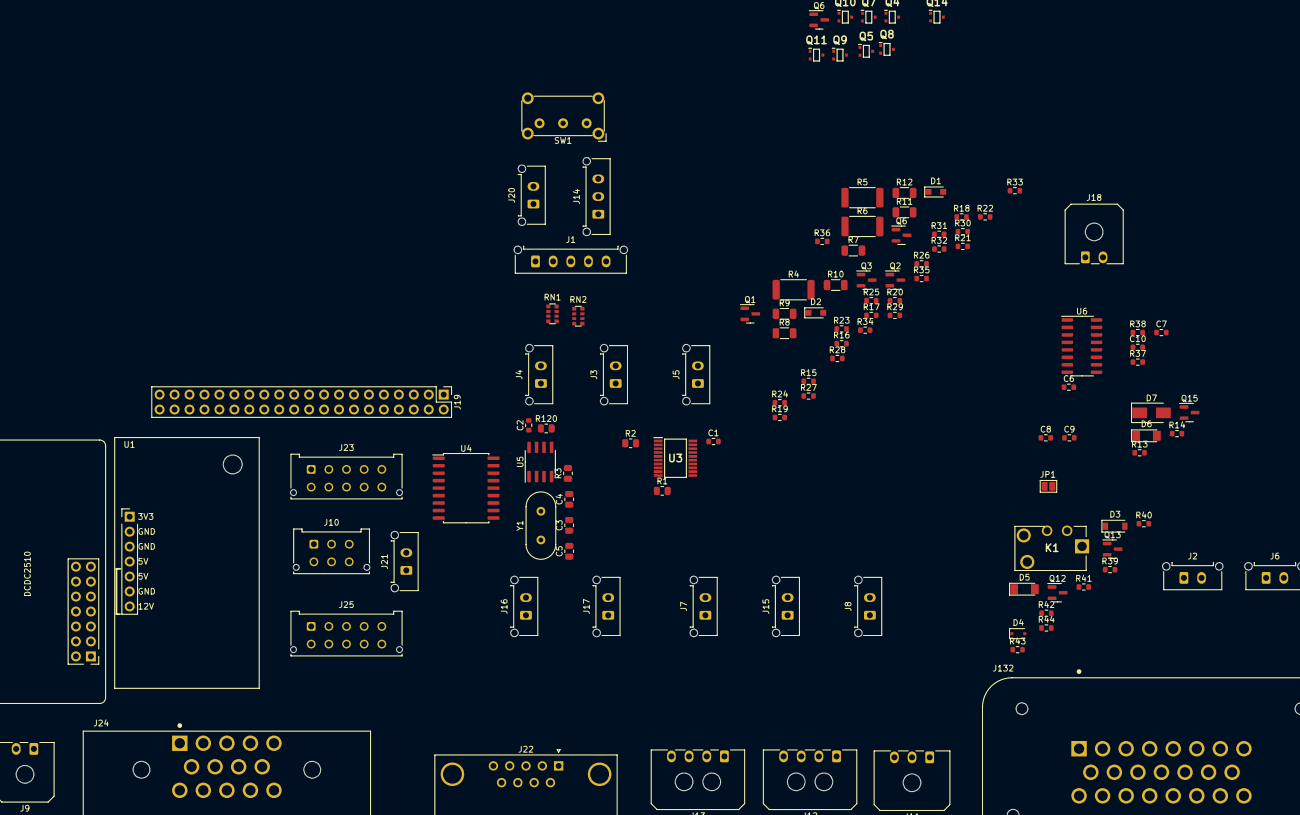
[picture p18: board handcart V6.kicad_pcb from above]

Board: 2 copper layers, 116 parts (0 on the bottom side), 121 nets, no tracks yet.

Parts:
C1, C2: 18pF; R_0603_1608Metric
C3, C4, C5: 100nF; R_0805_2012Metric
C6, C7, C8, C9, C10: 100nF; R_0603_1608Metric
D1, D2: 1N4148W; D_SOD-323_HandSoldering
D3: 1N4148W; D_SOD-123
D4: DDZ13ASF 13V; D_SOD-323F
D5, D6: RGL34B; D_MiniMELF
D7: SMAJ40CA; D_SMA
J1: Conn_01x05; Molex_Micro-Fit_3.0_43650-0515_1x05_P3.00mm_Vertical
J2, J3, J4, J5, J6, J7, J8, J15, J16, J17, J20, J21: Conn_01x02; Molex_Micro-Fit_3.0_43650-0215_1x02_P3.00mm_Vertical
J9, J18: Conn_01x02; Molex_Micro-Fit_3.0_43650-0200_1x02_P3.00mm_Horizontal
J10: Conn_02x03_Odd_Even; Molex_Micro-Fit_3.0_43045-0612_2x03_P3.00mm_Vertical
J11: Conn_01x03; Molex_Micro-Fit_3.0_43650-0300_1x03_P3.00mm_Horizontal
J12, J13: Conn_01x04; Molex_Micro-Fit_3.0_43650-0400_1x04_P3.00mm_Horizontal
J14: Conn_01x03; Molex_Micro-Fit_3.0_43650-0315_1x03_P3.00mm_Vertical
J19: Raspberry_Pi_2_3; raspberrypi_hat_template
J22: DB9_Female_DCE; DSUB-9_Female_Horizontal_P2.77x2.84mm_EdgePinOffset7.70mm_H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
J23: Conn_02x05; Molex_Micro-Fit_3.0_43045-1012_2x05_P3.00mm_Vertical
J24: TE_AmpSeal_14_776273-1; TE_776266-4
J25: Conn_02x06_Top_Bottom; Molex_Micro-Fit_3.0_43045-1012_2x05_P3.00mm_Vertical
J132: TE_Ampseal_23; TE_1-776228-4
JP1: SolderJumper_2_Open; SolderJumper-2_P1.3mm_Open_Pad1.0x1.5mm
K1: EX12U1S
Q1, Q6, Q6#2, Q15: 2N7002NXAK; SOT-23
Q2, Q3, Q13: NTR5105PT1G; SOT-23
Q4, Q5, Q7, Q8, Q9, Q10, Q11, Q14: SSM3K361TU,LF; SOTFL65P210X75-3N
Q12: 2N7002NXAKR; SOT-23
R1, R2, R3: 10k; R_0805_2012Metric
R4, R5, R6: 120R; R_2512_6332Metric
R7, R8, R9, R10, R11, R12: R; R_1206_3216Metric
R13: 33; R_0603_1608Metric
R14, R37, R38: 10k; R_0603_1608Metric
R15, R16, R17, R21, R23, R25, R27, R29, R31, R33, R35, R39, R41, R43: 22; R_0603_1608Metric
R18, R19, R20, R22, R24, R26, R28, R30, R32, R34, R36, R40, R42, R44: 330k; R_0603_1608Metric
R120: R; R_0805_2012Metric
RN1, RN2: 100k; R_Array_Convex_4x0612
SW1: SW_SPDT; SW_E-Switch_EG1224_SPDT_Angled
U1: Tex_DCDC_v2; Tex_DCDC_v2_horizontal
U2: DCDC2510; DCDC2510_Horizontal
U3: PCA9634PW,118; SOP65P640X110-20N
U4: MCP2515-xSO; SOIC-18W_7.5x11.6mm_P1.27mm
U5: MCP2562-E-SN; SOIC-8_3.9x4.9mm_P1.27mm
U6: MAX3232CDR; SOIC-16_3.9x9.9mm_P1.27mm
Y1: 16MHz; Crystal_HC49-4H_Vertical

Connections:
+3.3V: C7.1, J1.1, R37.1, R38.1, RN1.1 (R1.1), RN1.2 (R2.1), RN1.3 (R3.1), RN1.4 (R4.1), RN2.1 (R1.1), RN2.2 (R2.1), RN2.3 (R3.1), RN2.4 (R4.1), U6.16 (VCC)
+3V3: C3.1, C4.1, J14.2, J19.1 (3V3), J19.17 (3V3), R1.1, R2.1, R3.1, U1.1 (3V3), U3.1 (A0), U3.3 (A2), U3.5 (A4), U3.20 (VDD), U4.18 (VDD), U5.5 (Vio)
+5V: C5.1, D1.1 (K), J14.1, J15.1, J19.2 (5V), J19.4 (5V), J20.1, Q2.2 (S), Q3.2 (S), U1.4 (5V), U1.5 (5V), U5.3 (VDD)
+12V: D3.1 (K), J12.1, J13.1, J24.13, J132.1, K1.3, U2.11 (VDD), U2.12 (VDD), U2.13 (VDD), U2.14 (VDD)
+24V: D2.1 (K), J8.1, J9.1, J21.1, J24.11, J132.2, U1.7 (VIN), U2.1 (VCC), U2.2 (VCC), U2.3 (VCC), U2.4 (VCC)
/BMS_LED: J132.13, R17.1
/BRUSA_RX: J24.4, SW1.2 (B)
/BRUSA_TX: J22.2, J24.3, U6.8 (R2IN)
/BUT_0: J1.5, J19.15 (GPIO22), RN1.5 (R4.2)
/BUT_1: J2.1, J19.16 (GPIO23), RN1.6 (R3.2)
/BUT_2: J3.1, J19.18 (GPIO24), RN1.7 (R2.2)
/BUT_3: J4.1, J19.37 (GPIO26), RN1.8 (R1.2)
/BUT_4: J5.1, J19.13 (GPIO27), RN2.5 (R4.2)
/CAN_N: J11.2, J24.2, J132.6, R120.2, U5.6 (CANL)
/CAN_P: J11.1, J24.1, J132.5, R120.1, U5.7 (CANH)
/DISCHARGE_N: D7.1 (A1), J18.2, Q15.3 (D)
/DISCHARGE_P: D6.1 (K), D7.2 (A2), J18.1
/GREEN_TS_OFF: J15.2, R4.2
/IMD_LED: J132.12, R16.1
/NC_BMS_1: J23.1, J132.7
/NC_BMS_2: J23.2, J132.8
/NC_BMS_3: J23.3, J132.9
/NC_BMS_4: J23.4, J132.10
/NC_BMS_5: J23.5, J132.14
/NC_BMS_6: J23.6, J132.20
/NC_BMS_7: J23.7, J132.21
/NC_BMS_8: J23.8, J132.22
/NC_BMS_9: J23.9, J132.23
/NC_CRG_1: J10.1, J24.8
/NC_CRG_2: J10.2, J24.9
/NC_CRG_3: J10.3, J24.10
/Output/ADD_FAN_PWM: R35.2, U3.11 (LED4)
/Output/RASPY_FAN_PWM: R33.2, U3.12 (LED5)
/Output/RASPY_STRIP1_B: R31.2, U3.8 (LED2)
/Output/RASPY_STRIP1_G: R29.2, U3.7 (LED1)
/Output/RASPY_STRIP1_R: R27.2, U3.6 (LED0)
/Output/RASPY_TSAL_B: R25.2, U3.13 (LED6)
/Output/RASPY_TSAL_G: R23.2, U3.14 (LED7)
/Output/RASPY_TSAL_R: R21.2, U3.9 (LED3)
/PON: J24.5, Q13.3 (D)
/RASP_PON_CHARGER: J19.35 (GPIO19/MISO1), R13.2
/RASP_PON_CONTROL: J19.40 (GPIO21/SCLK1), R43.2
/RASP_SD_CONTROL: J19.38 (GPIO20/MOSI1), R39.2
/RED_BMS_FAULT: J16.1, R5.1
/RED_IMD_FAULT: J17.1, R6.1
/RESET_BUTTON: J6.1, J132.19
/ROT_A: J1.3, J19.36 (GPIO16), RN2.6 (R3.2)
/ROT_B: J1.4, J19.11 (GPIO17), RN2.7 (R2.2)
/RS_232/PC_TX: J22.3, SW1.3 (C)
/RS_232/RASP_RX: J19.10 (GPIO15/RXD), U6.9 (R2OUT)
/RS_232/RASP_TX: J19.8 (GPIO14/TXD), R37.2, U6.10 (T2IN)
/RS_232/RASP_TX_RS232: SW1.1 (A), U6.7 (T2OUT)
/Raspberry/CAN_~INT: J19.22 (GPIO25), U4.12 (~INT)
/Raspberry/NC_RASP_1: J19.29 (GCLK1/GPIO5), J25.1
/Raspberry/NC_RASP_2: J19.31 (GCLK2/GPIO6), J25.2
/Raspberry/NC_RASP_3: J19.26 (~CE1/GPIO7), J25.3
/Raspberry/NC_RASP_4: J19.32 (PWM0/GPIO12), J25.4
/Raspberry/NC_RASP_5: J19.33 (PWM1/GPIO13), J25.5
/Raspberry/NC_RASP_6: J19.27 (ID_SD/GPIO0), J25.6
/Raspberry/NC_RASP_7: J19.28 (ID_SC/GPIO1), J25.7
/Raspberry/NC_RASP_8: J19.12 (GPIO18/PWM0), J25.8
/Raspberry/RASP_CLK: J19.23 (SCLK0/GPIO11), U4.13 (SCK)
/Raspberry/RASP_MISO: J19.21 (MISO0/GPIO9), U4.15 (SO)
/Raspberry/RASP_MOSI: J19.19 (MOSI0/GPIO10), U4.14 (SI)
/Raspberry/RASP_~CS: J19.24 (~CE0/GPIO8), U4.16 (~CS)
/Raspberry/SCL: J19.5 (SCL/GPIO3), R2.2, U3.18 (SCL)
/Raspberry/SDA: J19.3 (SDA/GPIO2), R1.2, U3.19 (SDA)
/Raspberry/~OE: J19.7 (GCLK0/GPIO4), R3.2, U3.15 (~OE)
/SD_BMS_IN: J24.7, J132.16
/SD_BMS_OUT: D6.2 (A), J7.2, J132.17
/SD_END: D4.1 (K), D5.2 (A), J7.1, Q13.2 (S), R42.1
/SD_END_HV: D5.1 (K), J132.18
/SD_FROM_MUSHROOM: J8.2, JP1.1 (A), K1.1
/SD_TO_CHARGER: J24.6, JP1.2 (B), K1.4
/STRIP1_B: J13.4, R12.2
/STRIP1_G: J13.3, R11.2
/STRIP1_R: J13.2, R10.2
/TSAL: J132.11, R15.1
/TSAL_B: J12.4, R9.2
/TSAL_G: J12.3, R8.2
/TSAL_R: J12.2, R7.2
GND: C1.2, C2.2, C3.2, C4.2, C5.2, C7.2, C9.2, C10.2, D4.2 (A), J1.2, J2.2, J3.2, J4.2, J5.2, J6.2, J9.2, J11.3, J14.3, J16.2, J17.2, J19.6 (GND), J19.9 (GND), J19.14 (GND), J19.20 (GND), J19.25 (GND), J19.30 (GND), J19.34 (GND), J19.39 (GND), J22.7, J24.12, J24.14, J132.3, J132.4, J132.15, Q1.2 (S), Q4.2 (S), Q5.2 (S), Q6.2 (S), Q6#2.2 (S), Q7.2 (S), Q8.2 (S), Q9.2 (S), Q10.2 (S), Q11.2 (S), Q12.2 (S), Q14.2 (S), Q15.2 (S), R14.2, R18.2, R19.2, R20.2, R22.2, R24.2, R26.2, R28.2, R30.2, R32.2, R34.2, R36.2, R40.2, R44.2, U1.2 (GND), U1.3 (GND), U1.6 (GND), U2.5 (GND), U2.6 (GND), U2.7 (GND), U2.8 (GND), U2.9 (GND), U2.10 (GND), U3.2 (A1), U3.4 (A3), U3.10 (VSS), U3.16 (A5), U3.17 (A6), U4.9 (VSS), U5.2 (VSS), U5.8 (STBY), U6.15 (GND)
unnamed: C1.1, U4.7 (OSC2), Y1.1
unnamed: C2.1, U4.8 (OSC1), Y1.2
unnamed: C6.1, U6.1 (C1+)
unnamed: C6.2, U6.3 (C1-)
unnamed: C8.1, U6.4 (C2+)
unnamed: C8.2, U6.5 (C2-)
unnamed: C9.1, U6.6 (VS-)
unnamed: C10.1, U6.2 (VS+)
unnamed: D1.2 (A), J20.2, Q6.3 (D), Q6#2.3 (D)
unnamed: D2.2 (A), J21.2, Q9.3 (D)
unnamed: D3.2 (A), K1.2, Q14.3 (D)
unnamed: Q1.1 (G), R15.2, R18.1
unnamed: Q1.3 (D), R4.1
unnamed: Q2.1 (G), R16.2, R19.1
unnamed: Q2.3 (D), R5.2
unnamed: Q3.1 (G), R17.2, R20.1
unnamed: Q3.3 (D), R6.2
unnamed: Q7.3 (D), R9.1
unnamed: Q11.3 (D), R12.1
unnamed: Q12.1 (G), R39.1, R40.1
unnamed: Q12.3 (D), R41.2
unnamed: Q13.1 (G), R41.1, R42.2
unnamed: Q15.1 (G), R13.1, R14.1
unnamed: Q4.3 (D), R7.1
unnamed: Q5.3 (D), R8.1
unnamed: Q8.3 (D), R10.1
unnamed: Q10.3 (D), R11.1
unnamed: Q4.1 (G), R21.1, R22.1
unnamed: Q5.1 (G), R23.1, R24.1
unnamed: Q7.1 (G), R25.1, R26.1
unnamed: Q8.1 (G), R27.1, R28.1
unnamed: Q10.1 (G), R29.1, R30.1
unnamed: Q11.1 (G), R31.1, R32.1
unnamed: Q6#2.1 (G), R33.1, R34.1
unnamed: Q9.1 (G), R35.1, R36.1
unnamed: R38.2, U6.11 (T1IN)
unnamed: Q14.1 (G), R43.1, R44.1
unnamed: U4.1 (TXCAN), U5.1 (TXD)
unnamed: U4.2 (RXCAN), U5.4 (RXD)
