eagletrt/handcart-hw/(commit log)

2021-07-31 First revision, all seems ok
    [430450600.stp, 430451000.stp, 430451612.stp, 430452012.stp, c-1461400-4-c3-3d.stp, handcart.kicad_pcb, handcart.sch, hat_minimum.dxf]
2021-07-31 added button labels on schematic
    [handcart.sch]
2021-08-03 added mounting holes
    [handcart.kicad_pcb, handcart.sch]
2021-08-04 added fan hole to pi
    [handcart.kicad_pcb, handcart.sch, hat_minimum.dxf]
2021-08-04 All mounting holes to M3
    [handcart.kicad_pcb]
2021-08-08 as printed v2
    [handcart.kicad_pcb, handcart.sch]
2021-11-12 changed relay, modified gitignore, did the output
    [handcart.kicad_pcb, handcart.sch]
2021-11-20 missing holes added
    [430450600.stp, 430451000.stp, 430451612.stp, 430452012.stp, c-1461400-4-c3-3d.stp, handcart.kicad_pcb, handcart.sch]
2021-12-01 renamed SD nets
    [handcart.sch]
2023-02-04 added handcart hardware/ wiring documentation (#7)
2023-10-26 New version of the board. Added new features. For all of the changes refers to the documentation
    [Discharge.kicad_sch, Output.kicad_sch, RS_232.kicad_sch, Raspberry.kicad_sch, Shutdown.kicad_sch, handcart V6.kicad_pcb, handcart V6.kicad_sch, handcart.kicad_pcb]
2023-10-26 Changed mosfet, fixed all the datasheets, added 3D models
    [Output.kicad_sch, RS_232.kicad_sch, Raspberry.kicad_sch, Shutdown.kicad_sch, handcart V6.kicad_pcb, handcart V6.kicad_sch]
2023-11-02 Major changes after the schematic review. Refer to Github for all the changes
    [Discharge.kicad_sch, Output.kicad_sch, RS_232.kicad_sch, Raspberry.kicad_sch, Shutdown.kicad_sch, Shutdown_Discharge.kicad_sch, handcart.kicad_pcb, handcart.kicad_sch]
2023-11-16 modified schematic and started design pcb
    [Output.kicad_sch, RS_232.kicad_sch, RS_232_FEEDBACK.kicad_sch, Raspberry.kicad_sch, Shutdown_Discharge.kicad_sch, handcart.kicad_pcb, handcart.kicad_sch]
2023-11-16 Fixed frequency of LPF, added reverse polarity protection
    [RS_232_FEEDBACK.kicad_sch, Raspberry.kicad_sch, Shutdown_Discharge.kicad_sch, handcart.kicad_sch]
2023-11-22 First version of the pcb layout
    [Output.kicad_sch, RS_232_FEEDBACK.kicad_sch, Raspberry.kicad_sch, Shutdown_Discharge.kicad_sch, handcart.kicad_pcb, handcart.kicad_sch]
2023-11-27 Second iteration of the board layout. Need to fix some traces
    [Output.kicad_sch, RS_232_FEEDBACK.kicad_sch, Raspberry.kicad_sch, handcart.kicad_pcb, handcart.kicad_sch]
2023-12-03 Added connector, fixed traces, first version of silkscreen
    [Output.kicad_sch, RS_232_FEEDBACK.kicad_sch, Raspberry.kicad_sch, handcart.kicad_sch]
2023-12-15 Fixed vias diameter, fixed width of the input trace to the DCDC, completed the front silkscreen and added the back silkscreen
    [handcart.kicad_sch]
2023-12-19 Fixed Schematic, fixed some traces. Still not finished
    [Indicators.kicad_sch, RS_232_FEEDBACK.kicad_sch, Raspberry.kicad_sch, Shutdown_Discharge.kicad_sch, handcart.kicad_sch]
2023-12-21 Fixed traces, modified silkscreen
    [RS_232_FEEDBACK.kicad_sch, handcart.kicad_sch]
2023-12-21 Added information on silkscreen
2023-12-22 production candidate
    cleaned graphics
    aligned connectors
    exported fabrication files
